dj140/ThunderScope/Hardware_V5.3_AD/FPGA_CFG_MGT_6.png

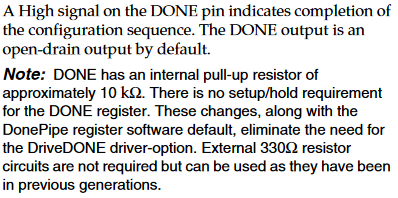
Hardware_V5.3_AD/FPGA_CFG_MGT_6.png
