dj140/ThunderScope/Hardware_V5.3_AD/FPGA_Bank_IO_1.png

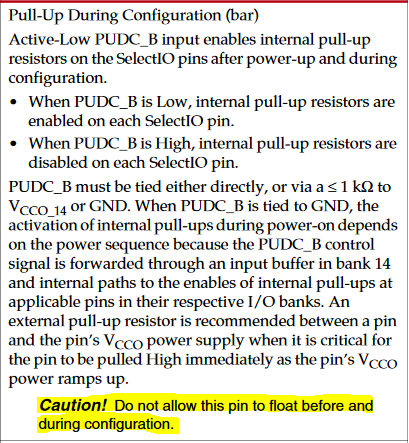
Hardware_V5.3_AD/FPGA_Bank_IO_1.png
