dj140/ThunderScope/Hardware_V5.3/Length Matching.ods

Input Net | Length | Output Net | Length |  | Total Length | Input Net Target Length | Reported Length
CH1_N | 40.2025 | 1/OUT_N | 10.1266 |  | 50.3291 | 63.8937 | 63.8717
CH1_P | 40.6287 | 1/OUT_P | 9.9265 |  | 50.5552 | 64.0938 | 64.0511
CH2_N | 39.9981 | 2/OUT_N | 5.8623 |  | 45.8604 | 68.158 | 68.1512
CH2_P | 40.4224 | 2/OUT_P | 5.861 |  | 46.2834 | 68.1593 | 68.151
CH3_N | 63.788 | 3/OUT_N | 5.8657 |  | 69.6537 | 68.1546 | 68.151
CH3_P | 64.2142 | 3/OUT_P | 5.8576 |  | 70.0718 | 68.1627 | 68.151
CH4_N | 63.4822 | 4/OUT_N | 9.9297 |  | 73.4119 | 64.0906 | 64.0984
CH4_P | 63.9084 | 4/OUT_P | 10.1119 |  | 74.0203 | 63.9084 | 63.9084
 |  |  |  | Longest | 74.0203
