dj140/ThunderScope/Hardware_V5.3_AD/FE_Channel_1.png

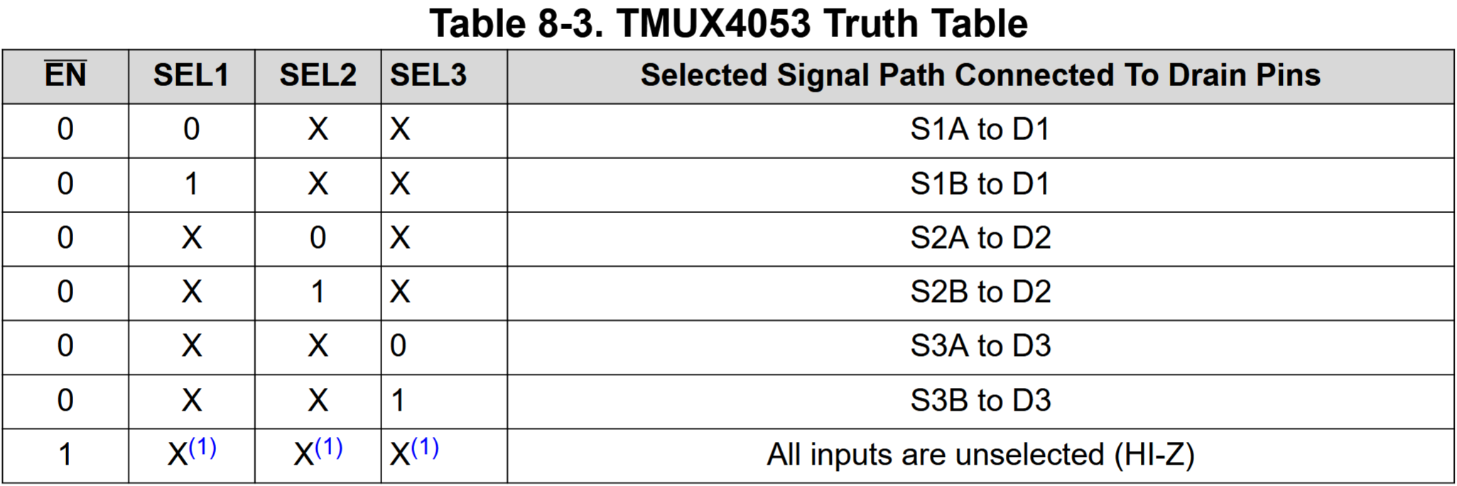
Hardware_V5.3_AD/FE_Channel_1.png
