dj140/ThunderScope/Hardware_V5.3_AD/FPGA_PWR_4.png

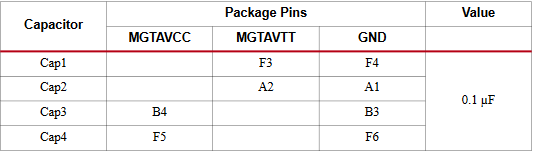
Hardware_V5.3_AD/FPGA_PWR_4.png
