dj140/ThunderScope/Hardware_V5.3_AD/PLL_1.png

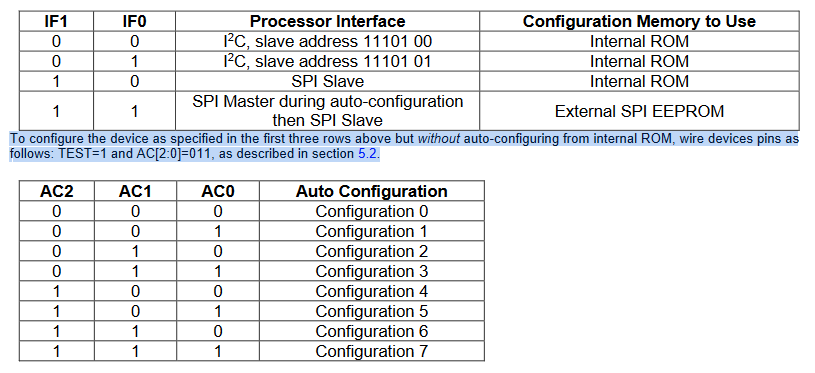
Hardware_V5.3_AD/PLL_1.png
