dj140/ThunderScope/Hardware_V5.3_AD/PnPout/Thunderscope_Rev5.3.xlsx

Comment | Designator | DesignItemId | Quantity
1uF | C1, C2, C3, C5, C6, C7, C8, C11, C16, C17, C18, C19, C24, C25, C48, C49, C50, C51, C52, C53, C54, C55, C56, C57, C58, C59, C60, C61, C62, C63, C68, C70_4_ADC Driver 1, C70_4_ADC Driver 2, C70_4_ADC Driver 3, C70_4_ADC Driver 4, C76, C78, C88, C89, C90, C91, C92, C102, C103, C104_4_ADC Driver 1, C104_4_ADC Driver 2, C104_4_ADC Driver 3, C104_4_ADC Driver 4, C105_4_ADC Driver 1, C105_4_ADC Driver 2, C105_4_ADC Driver 3, C105_4_ADC Driver 4, C112, C125, C126, C127, C130, C138, C139, C140, C141, C148, C149, C150, C151, C154, C155, C156, C157, C164, C165, C166, C167, C191, C1009_4_CH1, C1009_4_CH2, C1009_4_CH3, C1009_4_CH4, C1010_4_CH1, C1010_4_CH2, C1010_4_CH3, C1010_4_CH4, C1036_4_CH1, C1036_4_CH2, C1036_4_CH3, C1036_4_CH4, C1037_4_CH1, C1037_4_CH2, C1037_4_CH3, C1037_4_CH4, C1038_4_CH1, C1038_4_CH2, C1038_4_CH3, C1038_4_CH4, C1043_4_CH1, C1043_4_CH2, C1043_4_CH3, C1043_4_CH4, C1044_4_CH1, C1044_4_CH2, C1044_4_CH3, C1044_4_CH4, C1045_4_CH1, C1045_4_CH2, C1045_4_CH3, C1045_4_CH4, C1046_4_CH1, C1046_4_CH2, C1046_4_CH3, C1046_4_CH4, C1047_4_CH1, C1047_4_CH2, C1047_4_CH3, C1047_4_CH4, C1048_4_CH1, C1048_4_CH2, C1048_4_CH3, C1048_4_CH4, C1049_4_CH1, C1049_4_CH2, C1049_4_CH3, C1049_4_CH4, C1050_4_CH1, C1050_4_CH2, C1050_4_CH3, C1050_4_CH4, C1052_4_CH1, C1052_4_CH2, C1052_4_CH3, C1052_4_CH4, C1053_4_CH1, C1053_4_CH2, C1053_4_CH3, C1053_4_CH4, C1054_4_CH1, C1054_4_CH2, C1054_4_CH3, C1054_4_CH4, C1055_4_CH1, C1055_4_CH2, C1055_4_CH3, C1055_4_CH4, C1056_4_CH1, C1056_4_CH2, C1056_4_CH3, 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 | CAP 1uF 25V X5R 0402 | 150
100pF | C4, C74, C174, C178, C186, C1001_4_CH1, C1001_4_CH2, C1001_4_CH3, C1001_4_CH4, C1034_4_CH1, C1034_4_CH2, C1034_4_CH3, C1034_4_CH4, C1035_4_CH1, C1035_4_CH2, C1035_4_CH3, C1035_4_CH4 | CAP 100pF 50V C0G 0402 | 17
10uF | C9, C10, C14, C15, C20, C21, C23, C26, C69_4_ADC Driver 1, C69_4_ADC Driver 2, C69_4_ADC Driver 3, C69_4_ADC Driver 4, C71, C72, C73, C79, C85, C93, C94, C95, C96, C106, C107, C108, C109, C110, C111, C114, C115, C116, C117, C118, C119, C120, C121, C122, C142, C143, C146, C147, C158, C159, C162, C163, C168, C173, C175, C179, C181, C182, C183, C184, C187, C1003_4_CH1, C1003_4_CH2, C1003_4_CH3, C1003_4_CH4, C1004_4_CH1, C1004_4_CH2, C1004_4_CH3, C1004_4_CH4, C1005_4_CH1, C1005_4_CH2, C1005_4_CH3, C1005_4_CH4, C1006_4_CH1, C1006_4_CH2, C1006_4_CH3, C1006_4_CH4, C1007_4_CH1, C1007_4_CH2, C1007_4_CH3, C1007_4_CH4, C1008_4_CH1, C1008_4_CH2, C1008_4_CH3, C1008_4_CH4, C1039_4_CH1, C1039_4_CH2, C1039_4_CH3, C1039_4_CH4, C1040_4_CH1, C1040_4_CH2, C1040_4_CH3, C1040_4_CH4 | CAP 10uF 25V X5R 0603 | 85
22uF | C12, C22, C75, C80, C83, C84, C97, C98, C99, C101, C128, C176, C177, C180, C188, C1026_4_CH1, C1026_4_CH2, C1026_4_CH3, C1026_4_CH4, C1027_4_CH1, C1027_4_CH2, C1027_4_CH3, C1027_4_CH4, C1028_4_CH1, C1028_4_CH2, C1028_4_CH3, C1028_4_CH4, C1029_4_CH1, C1029_4_CH2, C1029_4_CH3, C1029_4_CH4 | CAP 22uF 25V X5R 0805 | 31
100nF | C13, C27, C44, C45, C46, C47, C65, C66, C67, C77, C81, C82, C123, C124, C129, C169, C170, C171, C172, C185, C189, C190, C1032_4_CH1, C1032_4_CH2, C1032_4_CH3, C1032_4_CH4, C1033_4_CH1, C1033_4_CH2, C1033_4_CH3, C1033_4_CH4, C1041_4_CH1, C1041_4_CH2, C1041_4_CH3, C1041_4_CH4, C1042_4_CH1, C1042_4_CH2, C1042_4_CH3, C1042_4_CH4 | CAP 100nF 16V X7R 0402 | 38
220nF | C28, C29, C30, C31, C32, C33, C34, C35, C36, C37, C38, C39, C40, C41, C42, C43 | CAP 220nF 16V X7R 0402 | 16
0 | C64, R2, R3, R4, R5, R25, R26, R27, R28, R29, R30, R31, R32, R33, R34, R35, R36, R37, R38, R39, R40, R41, R52_4_CH1, R52_4_CH2, R52_4_CH3, R52_4_CH4, R97_4_CH1, R97_4_CH2, R97_4_CH3, R97_4_CH4, R1053_4_CH1, R1053_4_CH2, R1053_4_CH3, R1053_4_CH4 | RES 0 OHM 1/16W 0402 | 34
47uF | C86, C87, C144, C145, C152, C153, C160, C161 | CAP 47uF 6.3V X5R 0805 | 8
18pF | C100, C1058_4_CH1, C1058_4_CH2, C1058_4_CH3, C1058_4_CH4 | CAP 18pF 50V C0G 0402 | 5
68pF | C1002_4_CH1, C1002_4_CH2, C1002_4_CH3, C1002_4_CH4 | CAP 68pF 50V C0G 0402 | 4
3pF | C1011_4_CH1, C1011_4_CH2, C1011_4_CH3, C1011_4_CH4, C1021_4_CH1, C1021_4_CH2, C1021_4_CH3, C1021_4_CH4, C1023_4_CH1, C1023_4_CH2, C1023_4_CH3, C1023_4_CH4 | CAP 3pF 200V C0G 0402 | 12
0.3pF | C1012_4_CH1, C1012_4_CH2, C1012_4_CH3, C1012_4_CH4 | CAP 0.3pF 100V Thin Film 0402 | 4
DNP | C1022_4_CH1, C1022_4_CH2, C1022_4_CH3, C1022_4_CH4 | CAP DNP 0603 | 4
1pF | C1024_4_CH1, C1024_4_CH2, C1024_4_CH3, C1024_4_CH4 | CAP 1pF 50V C0G 0402 | 4
8pF | C1025_4_CH1, C1025_4_CH2, C1025_4_CH3, C1025_4_CH4 | CAP 8pF 50V C0G 0402 | 4
1nF | C1030_4_CH1, C1030_4_CH2, C1030_4_CH3, C1030_4_CH4 | CAP 1nF 100V C0G 0603 | 4
10nF | C1031_4_CH1, C1031_4_CH2, C1031_4_CH3, C1031_4_CH4 | CAP 10nF 50V C0G 0603 | 4
2-6pF | C1059_4_CH1, C1059_4_CH2, C1059_4_CH3, C1059_4_CH4 | CAP TRIMMER 2-6PF 100V | 4
RGB | D1 | LED RGB 1204 APFA3010LSEKJ3ZGKQBC | 1
TPD1E1B04 | D2, D3, D4, D5 | TVS TPD1E1B04 | 4
1N4148WT-7 | D1000_4_CH1, D1000_4_CH2, D1000_4_CH3, D1000_4_CH4, D1001_4_CH1, D1001_4_CH2, D1001_4_CH3, D1001_4_CH4 | DIODE 1N4148 | 8
120@100MHZ | FB1, FB2, FB3, FB11, FB12, FB13, FB1000_4_CH1, FB1000_4_CH2, FB1000_4_CH3, FB1000_4_CH4, FB1001_4_CH1, FB1001_4_CH2, FB1001_4_CH3, FB1001_4_CH4, R91 | FERRITE BEAD 120 OHM 0402 | 15
BNC | J1, J2, J1002_4_CH1, J1002_4_CH2, J1002_4_CH3, J1002_4_CH4 | BNC JACK R/A | 6
1.27mm 6 Pin TH | J3 | CONN 1.27mm 2x5 Pin TH RA | 1
UFL | J3_4_CH1, J3_4_CH2, J3_4_CH3, J3_4_CH4, J4_4_CH1, J4_4_CH2, J4_4_CH3, J4_4_CH4 | UFL Jack SMD | 8
TSW-101-16-G-Q-RA | J4 | CONN 5.08mm 2 Pin TH RA | 1
2.54mm 6 Pin TH | J5 | CONN 2.54mm 6 Pin TH RA | 1
M.2 Key M | J8 | CONN M.2 Key M FEMALE | 1
F300-1B7H1-11036-E100 | J9 | CONN FFC BOTTOM 36POS 0.5MM RA | 1
HC-1.25-2PLT | J10 | CONN 1.27mm 2PIN | 1
UD2-4.5NUN-L | K1000_4_CH1, K1000_4_CH2, K1000_4_CH3, K1000_4_CH4, K1001_4_CH1, K1001_4_CH2, K1001_4_CH3, K1001_4_CH4 | RELAY DPDT-NO UD2-4.5NUN-L | 8
1uH | L1, L2, L3, L4, L5 | IND 1uH 5.5A 32 MOHM 1210 | 5
DMN62D0UW | Q1, Q2, Q3, Q1002_4_CH1, Q1002_4_CH2, Q1002_4_CH3, Q1002_4_CH4, Q1003_4_CH1, Q1003_4_CH2, Q1003_4_CH3, Q1003_4_CH4 | NMOS DMN62D0UW | 11
10K | R1, R8, R15, R16, R17, R45, R58, R59, R61, R62, R66, R67, R68, R72, R75, R76, R77, R78, R79, R80, R81, R82, R86, R87, R92, R94, R101, R108, R111, R117, R118, R121, R124, R128, R129, R130, R1029_4_CH1, R1029_4_CH2, R1029_4_CH3, R1029_4_CH4, R1030_4_CH1, R1030_4_CH2, R1030_4_CH3, R1030_4_CH4, R1031_4_CH1, R1031_4_CH2, R1031_4_CH3, R1031_4_CH4, R1032_4_CH1, R1032_4_CH2, R1032_4_CH3, R1032_4_CH4, R1033_4_CH1, R1033_4_CH2, R1033_4_CH3, R1033_4_CH4, R1044_4_CH1, R1044_4_CH2, R1044_4_CH3, R1044_4_CH4, R1052_4_CH1, R1052_4_CH2, R1052_4_CH3, R1052_4_CH4 | RES 10K OHM 1% 1/16W 0402 | 64
2K | R6, R64, R127, R1043_4_CH1, R1043_4_CH2, R1043_4_CH3, R1043_4_CH4 | RES 2K OHM 1% 1/16W 0402 | 7
100 | R7, R22, R60, R107, R112, R115 | RES 100 OHM 1% 1/10W 0402 | 6
4.7K | R9, R10, R11, R12, R46, R47, R69, R70, R73, R99, R102, R104, R113, R114, R119 | RES 4.7K OHM 1% 1/16W 0402 | 15
10K | R13 | RES ARRAY 2x 10K OHM 0.05% 0606 | 1
0.01 | R14, R42, R54, R57, R71, R89, R97, R98, R116, R120, R123, R126 | RES 0.01 OHM 1% 1/4W 0603 | 12
DNP | R18, R19, R20, R21, R1048_4_CH1, R1048_4_CH2, R1048_4_CH3, R1048_4_CH4 | RES DNP 0402 | 8
49.9 | R23, R24, R43, R63, R1037_4_CH1, R1037_4_CH2, R1037_4_CH3, R1037_4_CH4 | RES 49.9 OHM 1% 1/10W 0402 | 8
1K | R44, R48, R49, R50, R51, R52, R53, R65, R74, R85, R95, R125, R1001_4_CH1, R1001_4_CH2, R1001_4_CH3, R1001_4_CH4, R1045_4_CH1, R1045_4_CH2, R1045_4_CH3, R1045_4_CH4, R1046_4_CH1, R1046_4_CH2, R1046_4_CH3, R1046_4_CH4 | RES 1K OHM 1% 1/10W 0402 | 24
90.9k | R55, R96, R1041_4_CH1, R1041_4_CH2, R1041_4_CH3, R1041_4_CH4, R1042_4_CH1, R1042_4_CH2, R1042_4_CH3, R1042_4_CH4, R1047_4_CH1, R1047_4_CH2, R1047_4_CH3, R1047_4_CH4 | RES 90.9K OHM 1% 1/16W 0402 | 14
20k | R56, R100, R103, R105, R122, R1026_4_CH1, R1026_4_CH2, R1026_4_CH3, R1026_4_CH4 | RES 20K OHM 1% 1/16W 0402 | 9
35.7k | R88, R110, R1036_4_CH1, R1036_4_CH2, R1036_4_CH3, R1036_4_CH4 | RES 35.7K OHM 1% 1/16W 0402 | 6
0.1 | R90, R106 | RES 0.1 OHM 1% 1/6W 0402 | 2
280K | R93, R109 | RES 280K OHM 1% 1/16W 0402 | 2
120 | R131_4_ADC Driver 1, R131_4_ADC Driver 2, R131_4_ADC Driver 3, R131_4_ADC Driver 4 | RES 120 OHM 1% 1/16W 0402 | 4
300 | R132_4_ADC Driver 1, R132_4_ADC Driver 2, R132_4_ADC Driver 3, R132_4_ADC Driver 4, R133_4_ADC Driver 1, R133_4_ADC Driver 2, R133_4_ADC Driver 3, R133_4_ADC Driver 4, R134_4_ADC Driver 1, R134_4_ADC Driver 2, R134_4_ADC Driver 3, R134_4_ADC Driver 4, R135_4_ADC Driver 1, R135_4_ADC Driver 2, R135_4_ADC Driver 3, R135_4_ADC Driver 4 | RES 300 OHM 0.1% 1/16W 0402 | 16
4.99 | R136_4_ADC Driver 1, R136_4_ADC Driver 2, R136_4_ADC Driver 3, R136_4_ADC Driver 4, R137_4_ADC Driver 1, R137_4_ADC Driver 2, R137_4_ADC Driver 3, R137_4_ADC Driver 4 | RES 4.99 OHM 1% 1/16W 0402 | 8
976k | R1002_4_CH1, R1002_4_CH2, R1002_4_CH3, R1002_4_CH4, R1024_4_CH1, R1024_4_CH2, R1024_4_CH3, R1024_4_CH4 | RES 976k OHM 1% 1/10W 0402 | 8
10M | R1003_4_CH1, R1003_4_CH2, R1003_4_CH3, R1003_4_CH4, R1038_4_CH1, R1038_4_CH2, R1038_4_CH3, R1038_4_CH4 | RES 10M OHM 1% 1/10W 0603 | 8
15 | R1021_4_CH1, R1021_4_CH2, R1021_4_CH3, R1021_4_CH4 | RES 15 OHM 1% 1/3W 0603 | 4
30 | R1022_4_CH1, R1022_4_CH2, R1022_4_CH3, R1022_4_CH4, R1035_4_CH1, R1035_4_CH2, R1035_4_CH3, R1035_4_CH4 | RES 30 OHM 1% 1/3W 0603 | 8
49.9 | R1025_4_CH1, R1025_4_CH2, R1025_4_CH3, R1025_4_CH4 | RES 49.9 OHM 1% 1W 0508 | 4
22 | R1027_4_CH1, R1027_4_CH2, R1027_4_CH3, R1027_4_CH4, R1028_4_CH1, R1028_4_CH2, R1028_4_CH3, R1028_4_CH4 | RES 22 OHM 1% 1/3W 0603 | 8
909k | R1039_4_CH1, R1039_4_CH2, R1039_4_CH3, R1039_4_CH4 | RES 909K OHM 1% 1/16W 0402 | 4
2K TRIMPOT | R1049_4_CH1, R1049_4_CH2, R1049_4_CH3, R1049_4_CH4 | TRIMMER 2K OHM 0.1W J LEAD TOP | 4
2118728-2 | SHLD1001_4_CH1, SHLD1001_4_CH2, SHLD1001_4_CH3, SHLD1001_4_CH4 | SHIELD 2118728-2 | 4
SN74LVC1G17 | U1 | IC BUFFER SN74LVC1G17 | 1
MCP4452-104E | U2 | IC DIGIPOT QUAD MCP4452-104E | 1
MCP4728 | U3 | IC DAC QUAD MCP4728 | 1
REF2025 | U4 | IC VREF REF2025 | 1
OPA140AIDBVR | U5, U1011_4_CH1, U1011_4_CH2, U1011_4_CH3, U1011_4_CH4 | IC OPAMP OPA140 | 5
HMCAD1520 | U6 | IC ADC HMCAD1520 | 1
ZL30260LDG1 | U7 | IC CLK GEN ZL30260LDG1 | 1
TPS62A02 | U8, U20, U21, U23 | IC BUCK TPS62A02 | 4
NCP161ASN330T1G | U9, U16 | IC LDO NCP161ASN330T1G | 2
FIN1019MTCX | U10 | IC LVDS XCVR FIN1019MTCX | 1
TPSM82913 | U11 | IC BUCK MODULE TPSM82913 | 1
ADA4930-1YCPZ | U12_4_ADC Driver 1, U12_4_ADC Driver 2, U12_4_ADC Driver 3, U12_4_ADC Driver 4 | IC ADC DRIVER ADA4930-1YCPZ | 4
LM27761 | U13 | IC CPUMP LM27761 | 1
TPS7A9101 | U14, U15, U22 | IC LDO TPS7A9101 | 3
TPS61023 | U17 | IC BOOST TPS61023 | 1
IC FPGA XC7A50T-2CSG325C | U18 | IC FPGA XC7A50T-2CSG325C | 1
MX25L6433FZNI-08G | U19 | IC FLASH MX25L6433FZNI-08G | 1
TMUX4053 | U1001_4_CH1, U1001_4_CH2, U1001_4_CH3, U1001_4_CH4 | IC SWITCH 3X SPDT TMUX4053 | 4
LMH6518 | U1008_4_CH1, U1008_4_CH2, U1008_4_CH3, U1008_4_CH4 | IC PGA LMH6518 | 4
BUF802 | U1009_4_CH1, U1009_4_CH2, U1009_4_CH3, U1009_4_CH4 | IC BUFFER AMP BUF802 | 4
10MHz | Y1 | OSC 10MHz ECS-TXO-3225MV | 1
25MHz | Y2 | OSC 25MHz ECS-TXO-2016 | 1
