dj140/ThunderScope/Hardware_V5.3_AD/PnPout/Thunderscope_Rev5.3.pdf

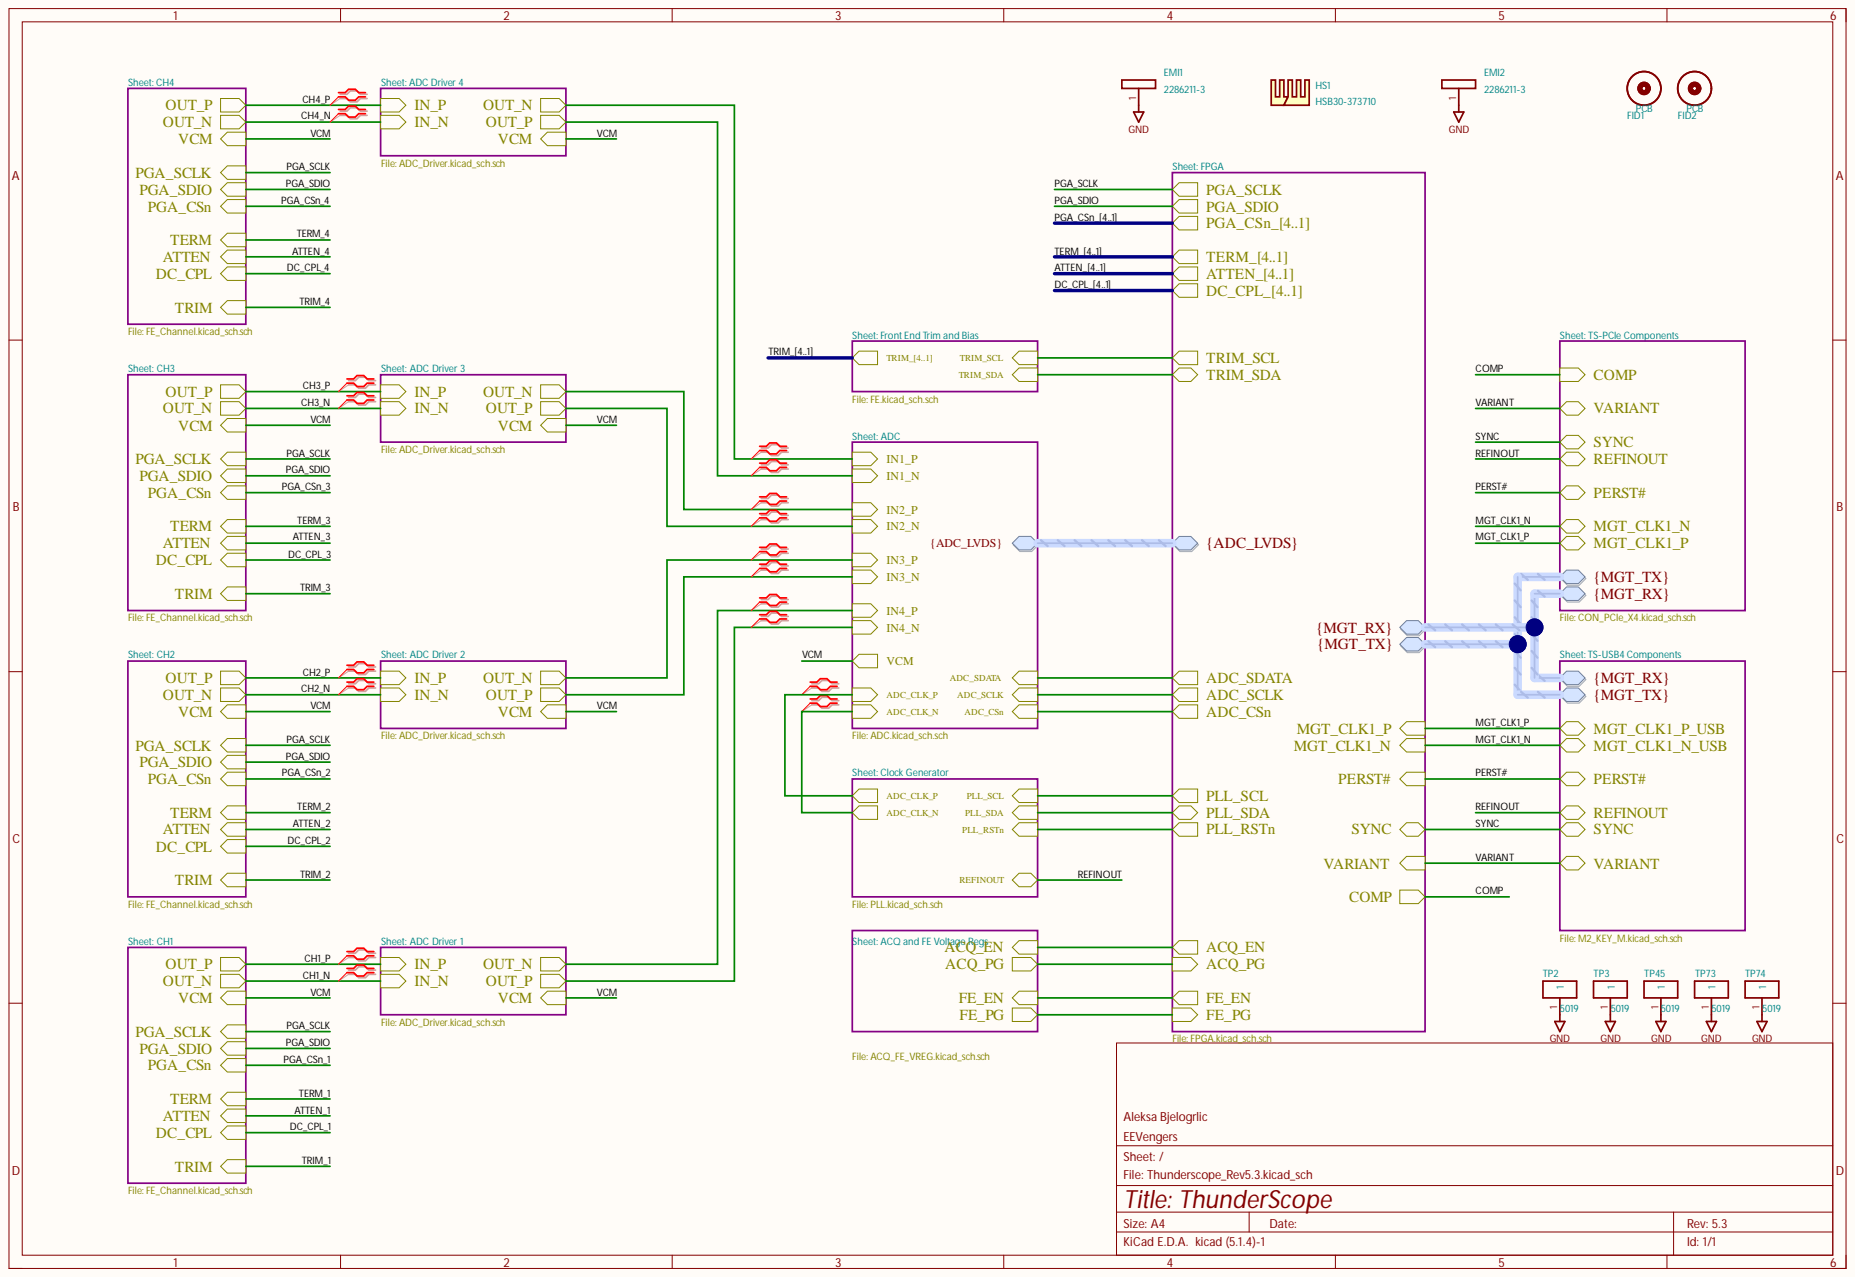
[picture p7: page 1]

Size: A4 | Date: | Rev: 5.3
K i Cad E.D.A. k i cad (5.1.4)-1 | | Id: 1/1

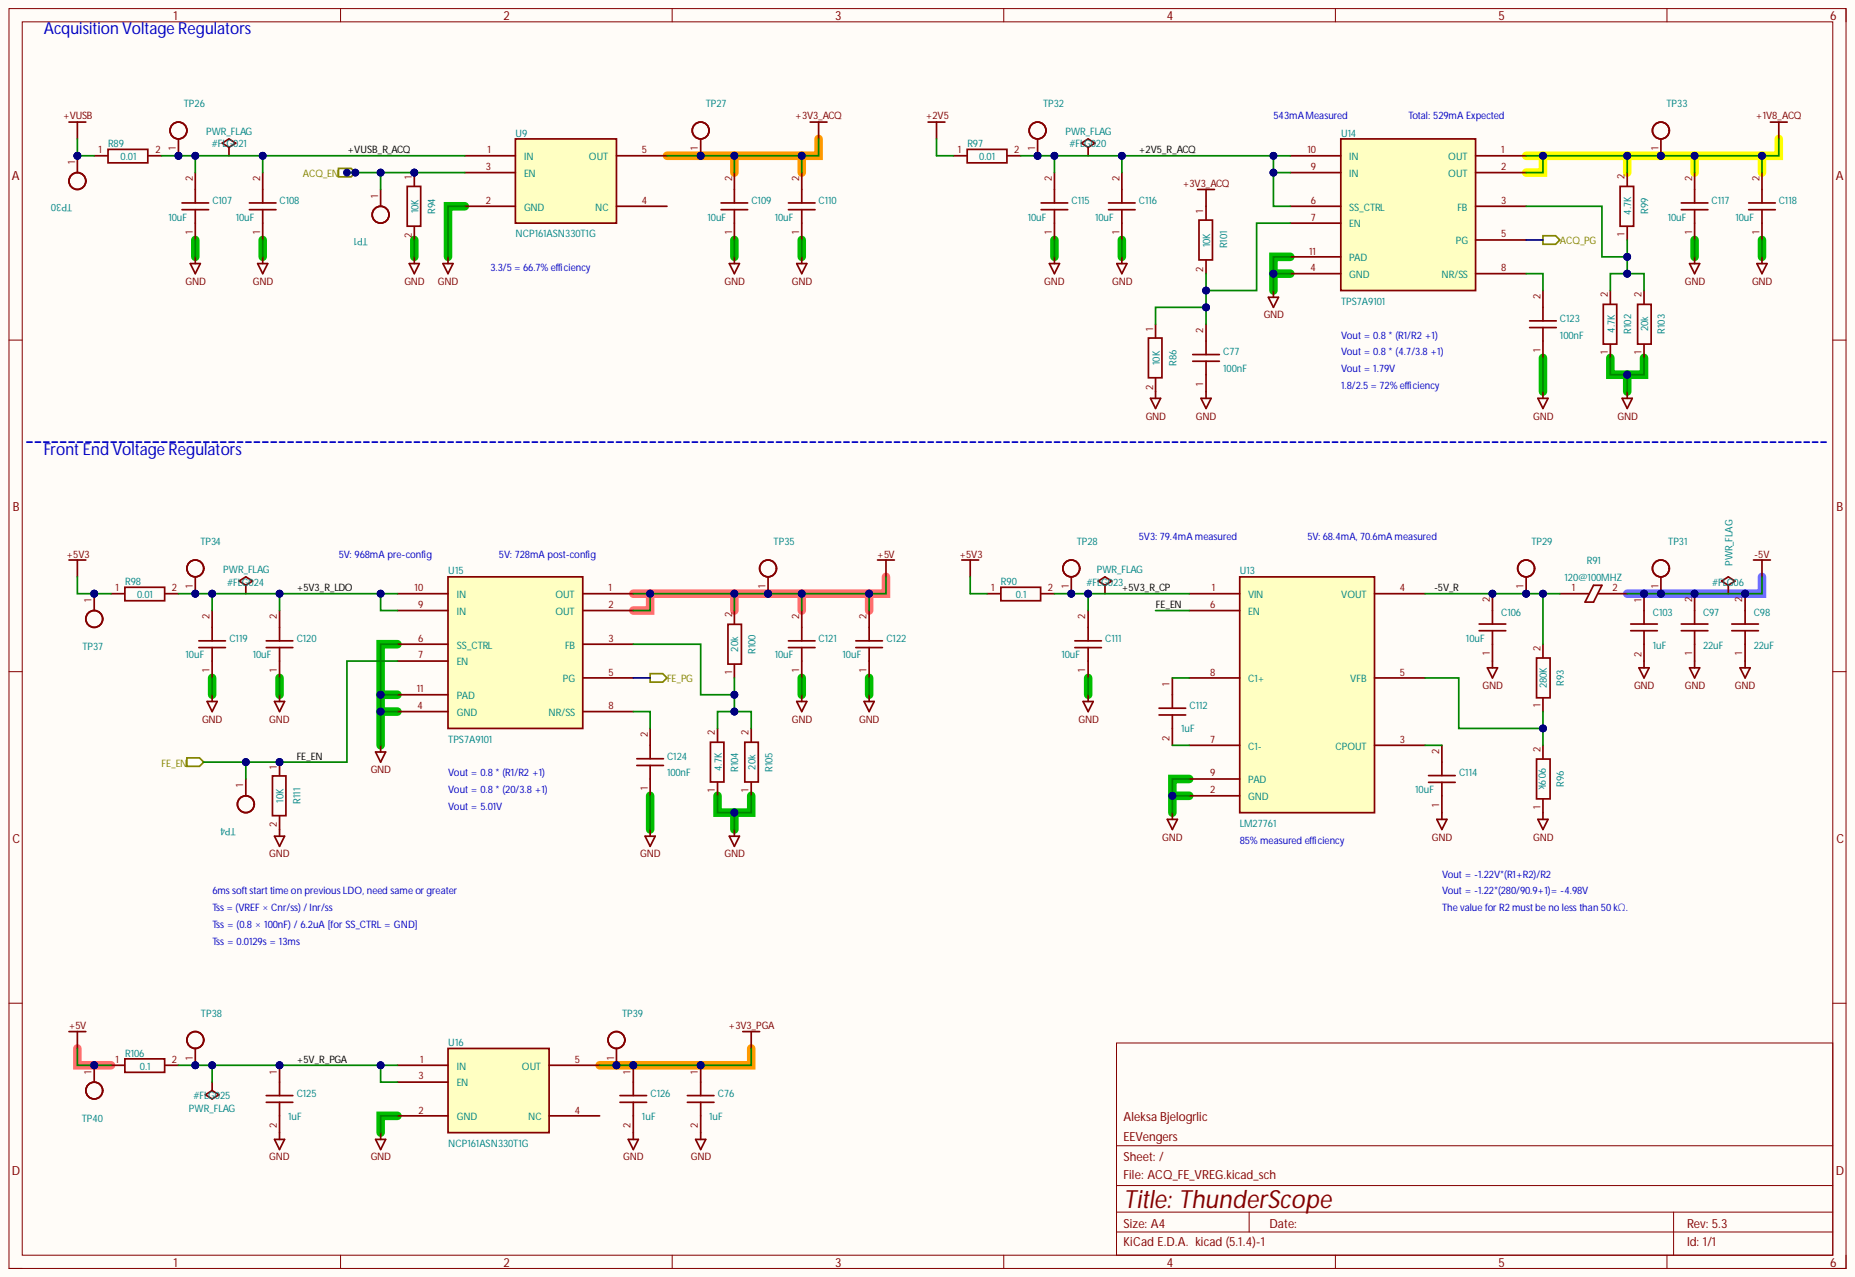
[picture p8: page 2]

Front End Voltage Regulators

6ms soft start time on previous LDO, need same or greater
Tss = (0.8 × 100nF) / 6.2uA [for SS_CTRL = GND]
Tss = 0.0129s = 13ms

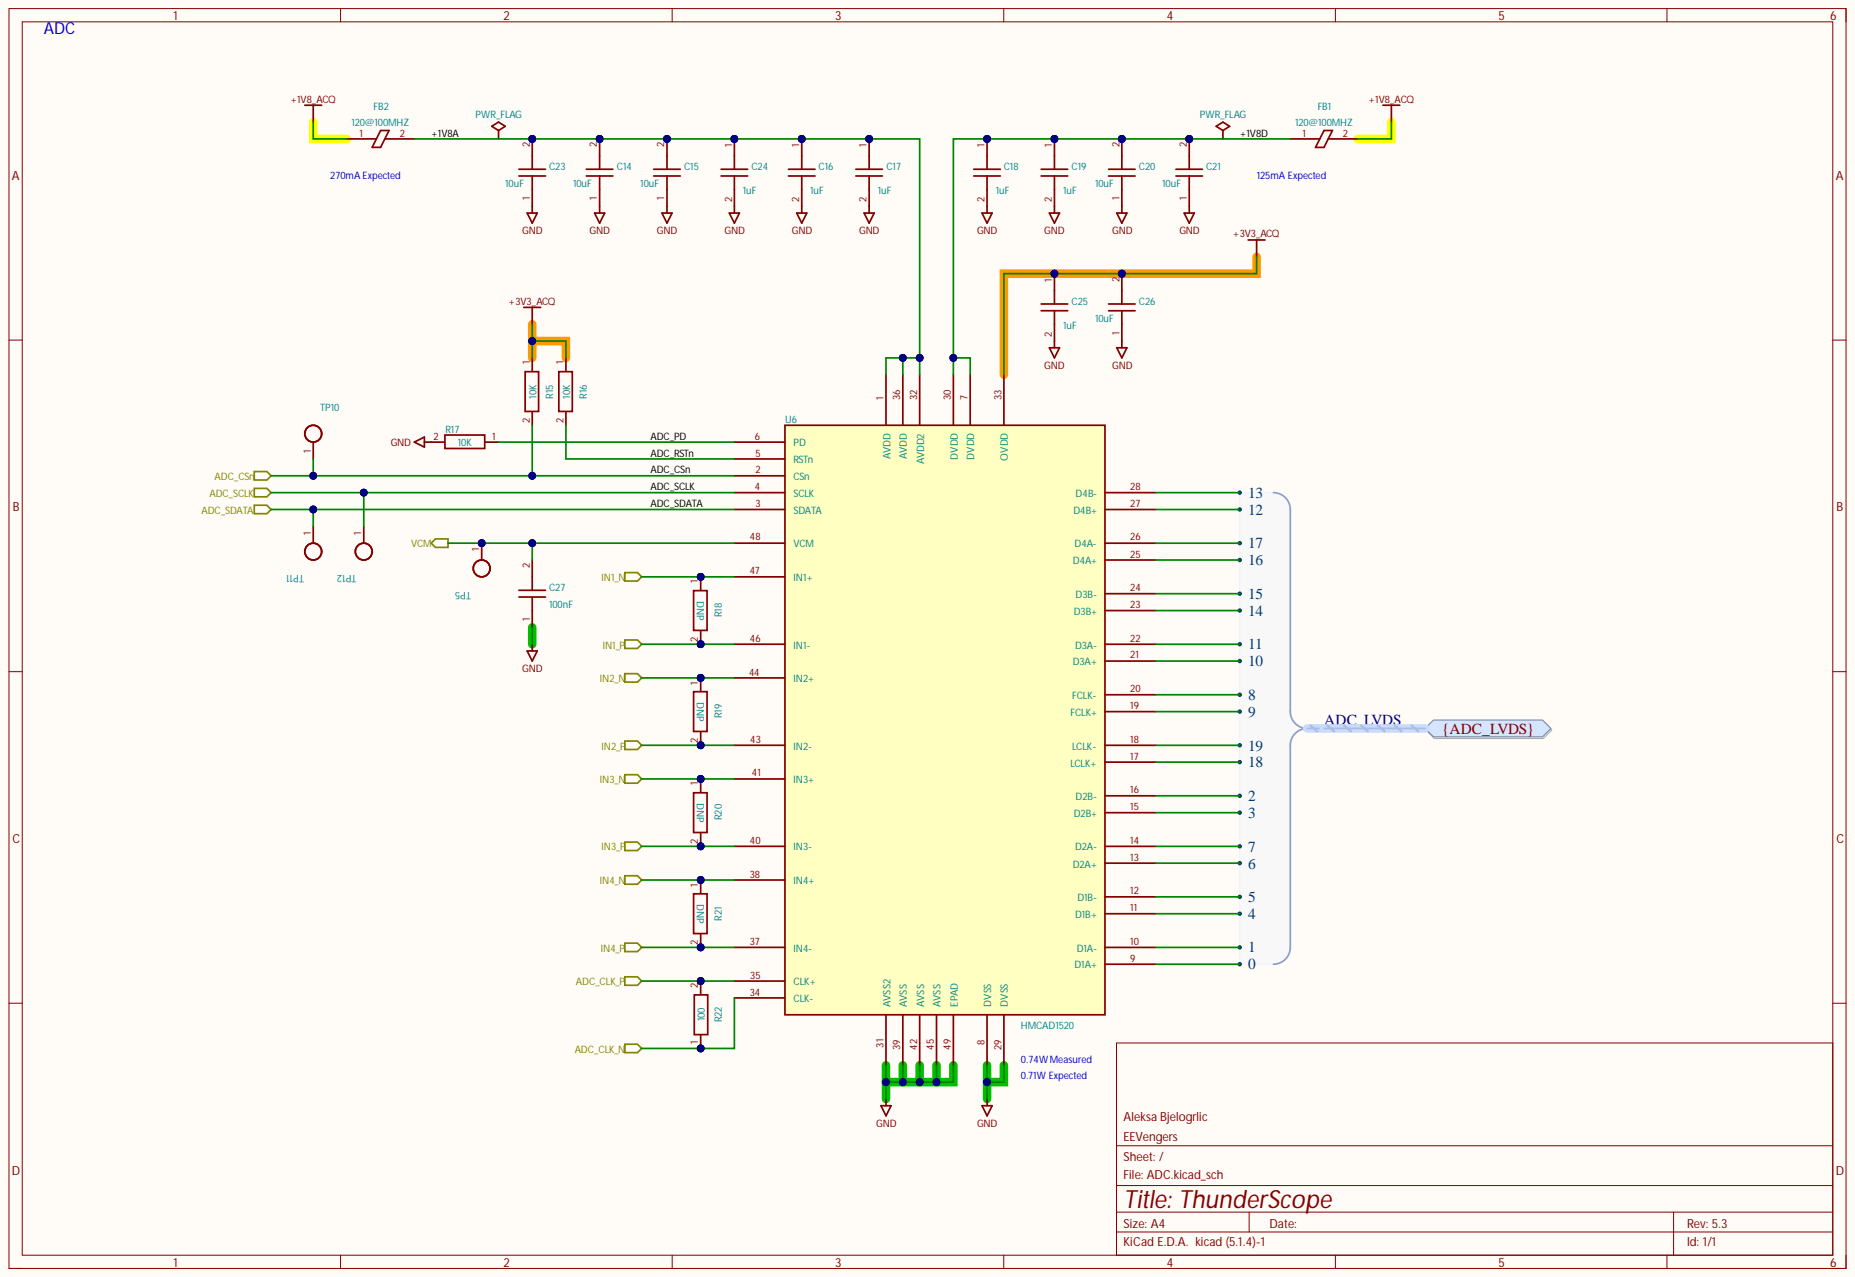
[picture p9: page 3]

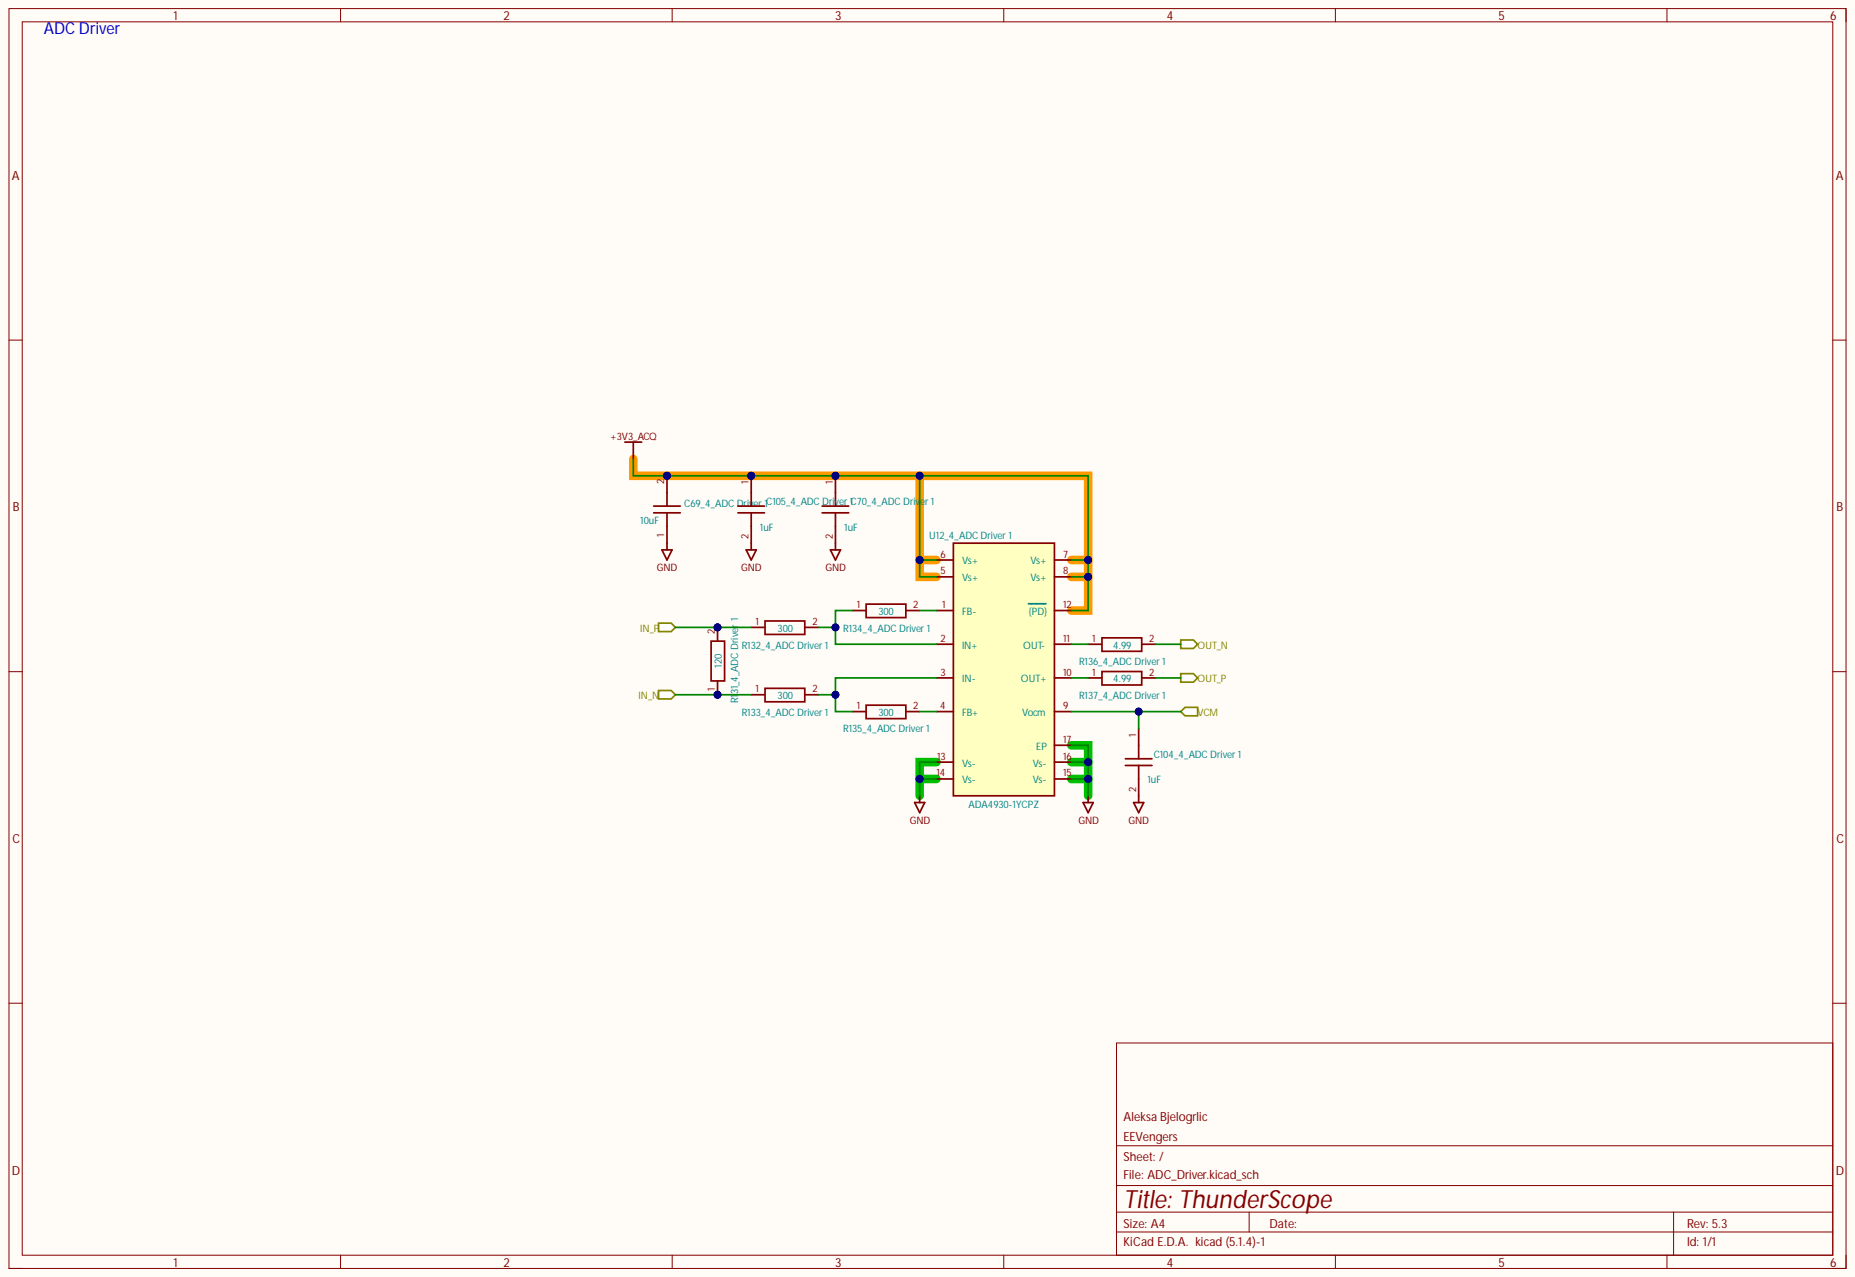
[picture p10: page 4]

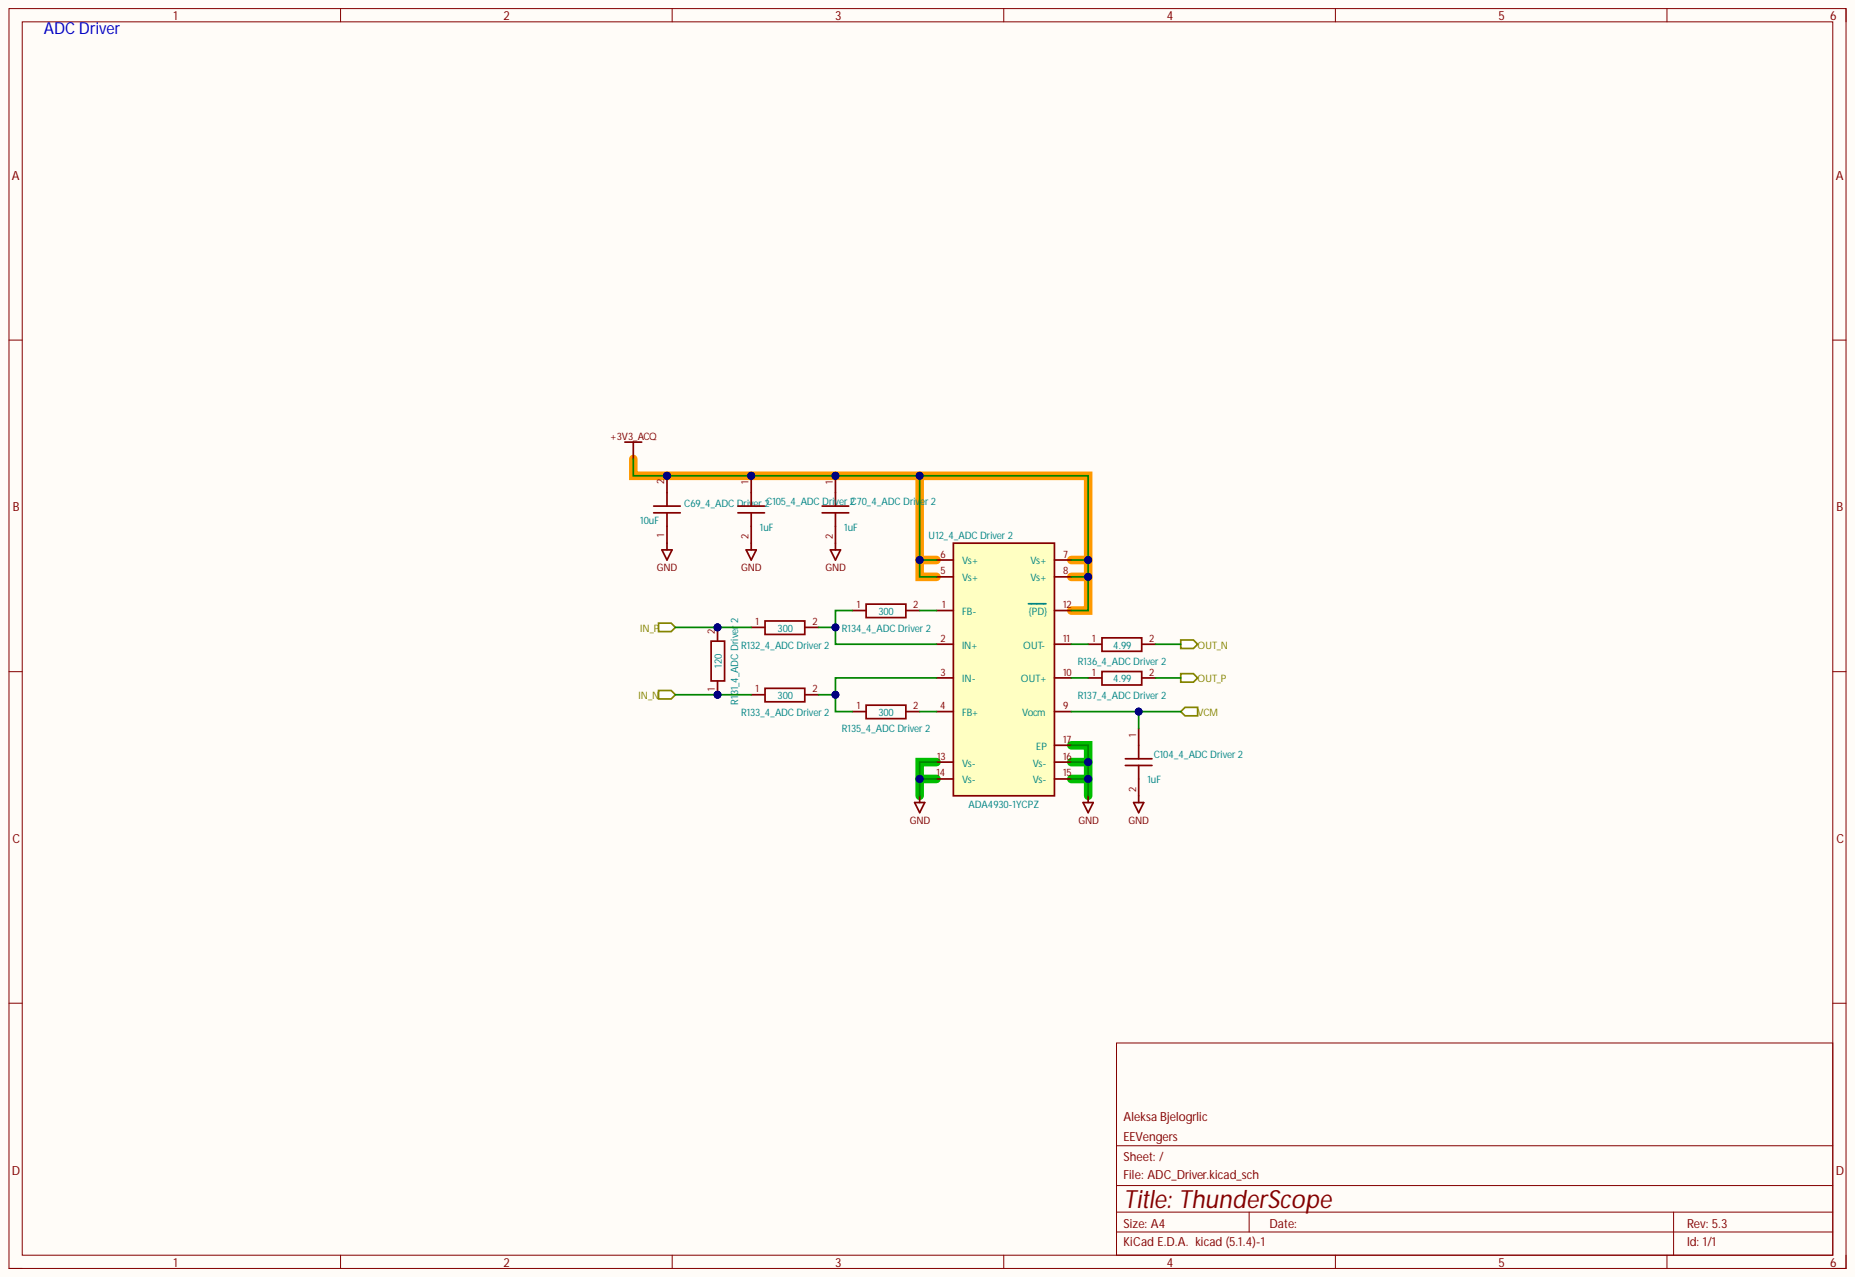
[picture p11: page 5]

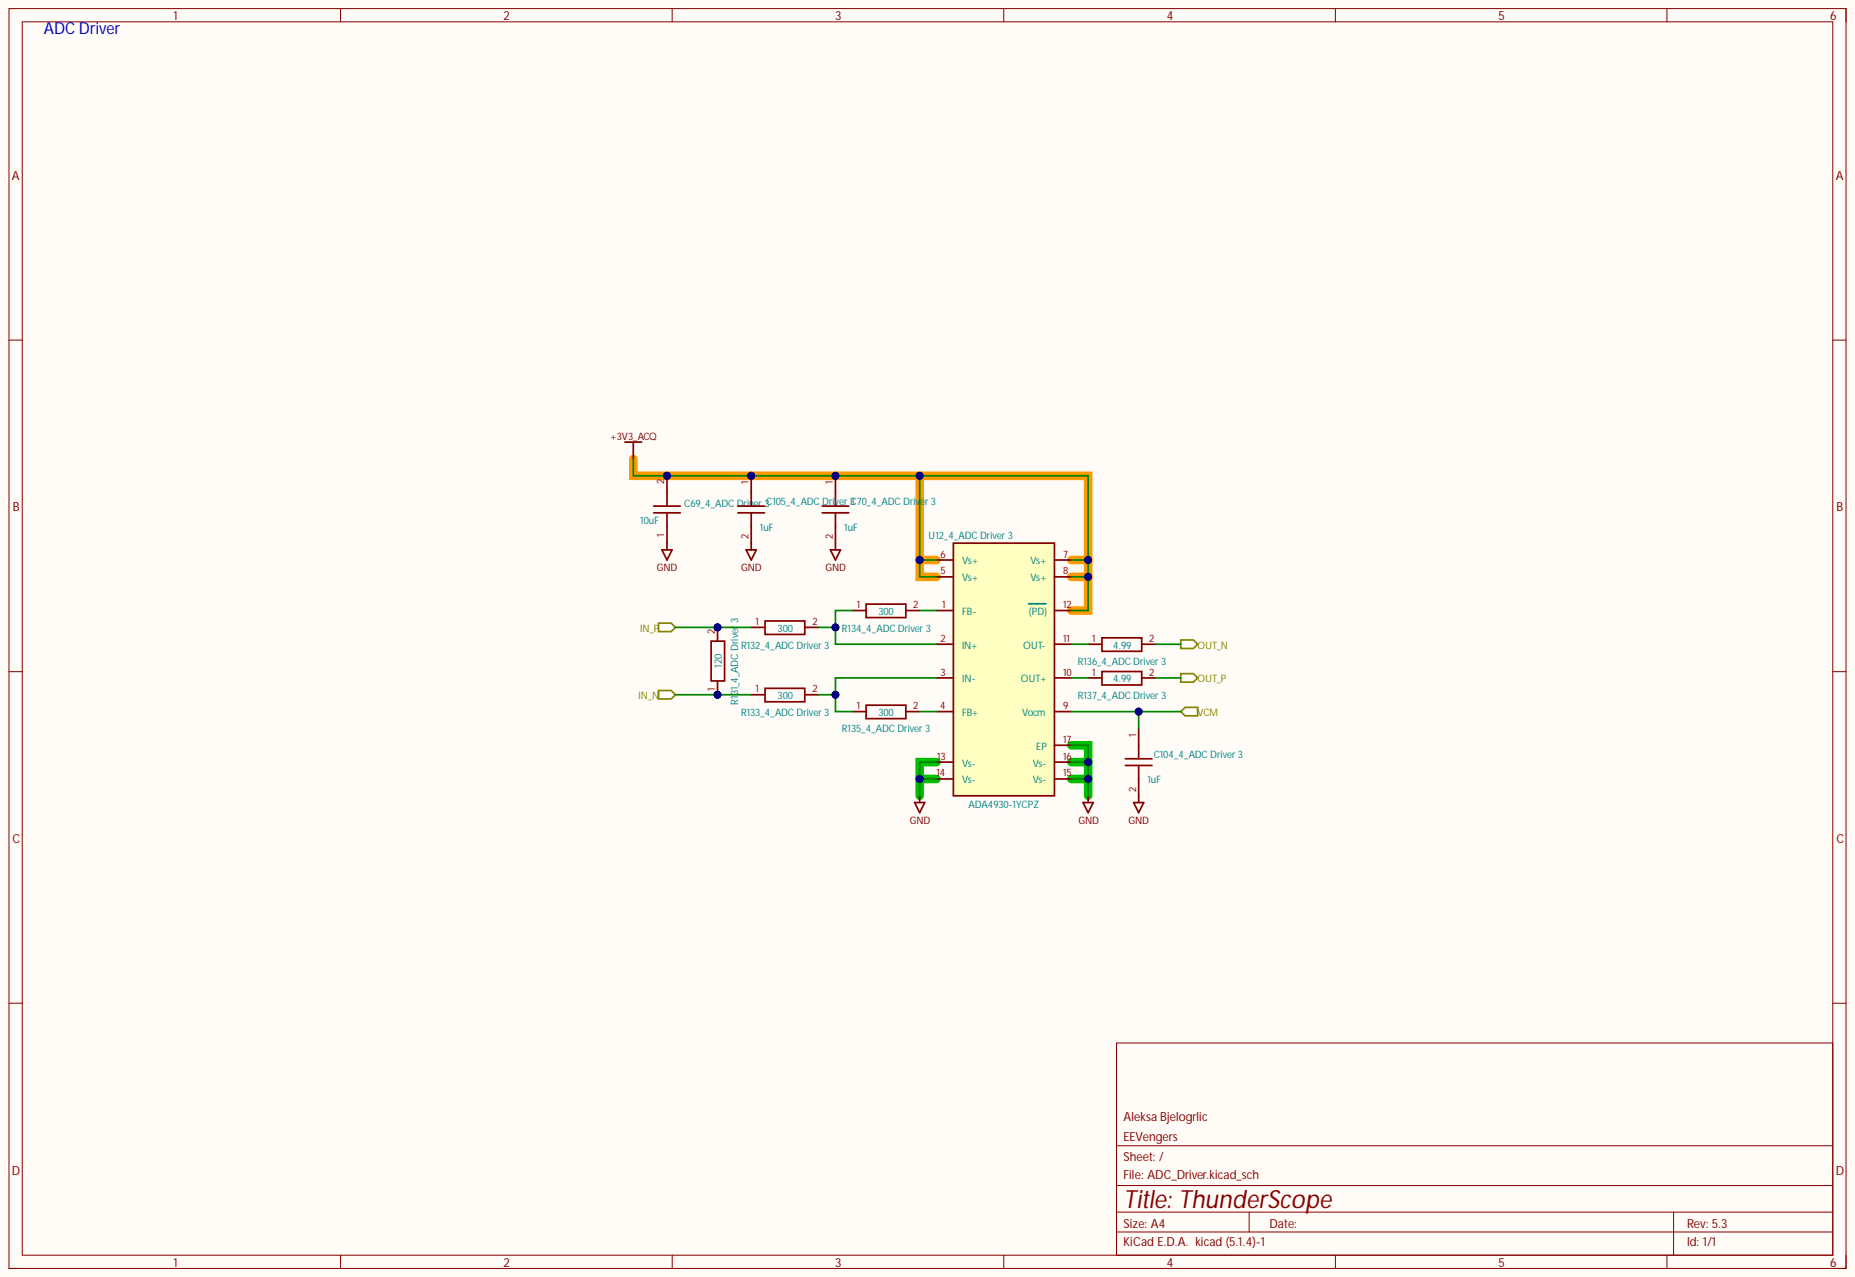
[picture p12: page 6]

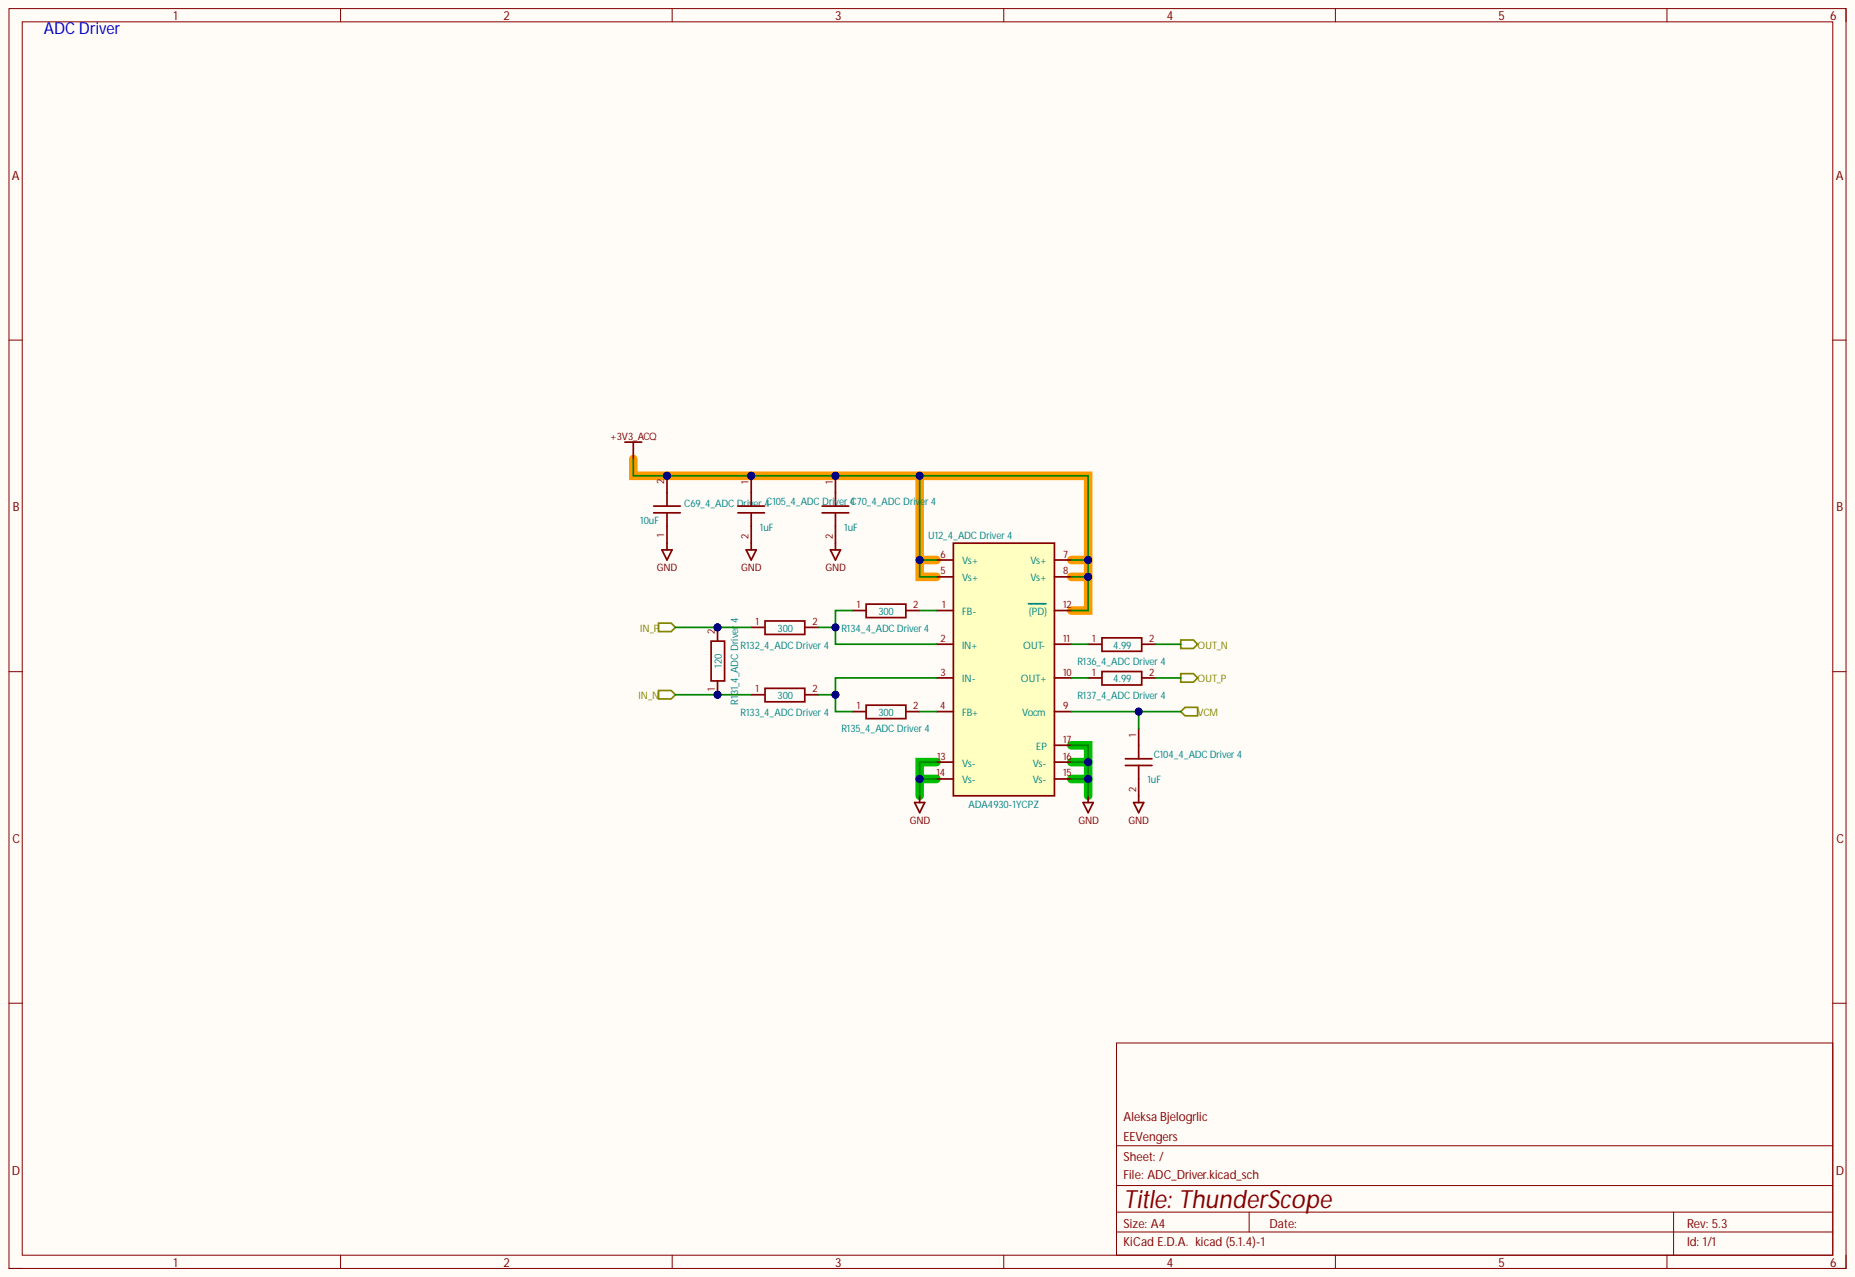
[picture p13: page 7]

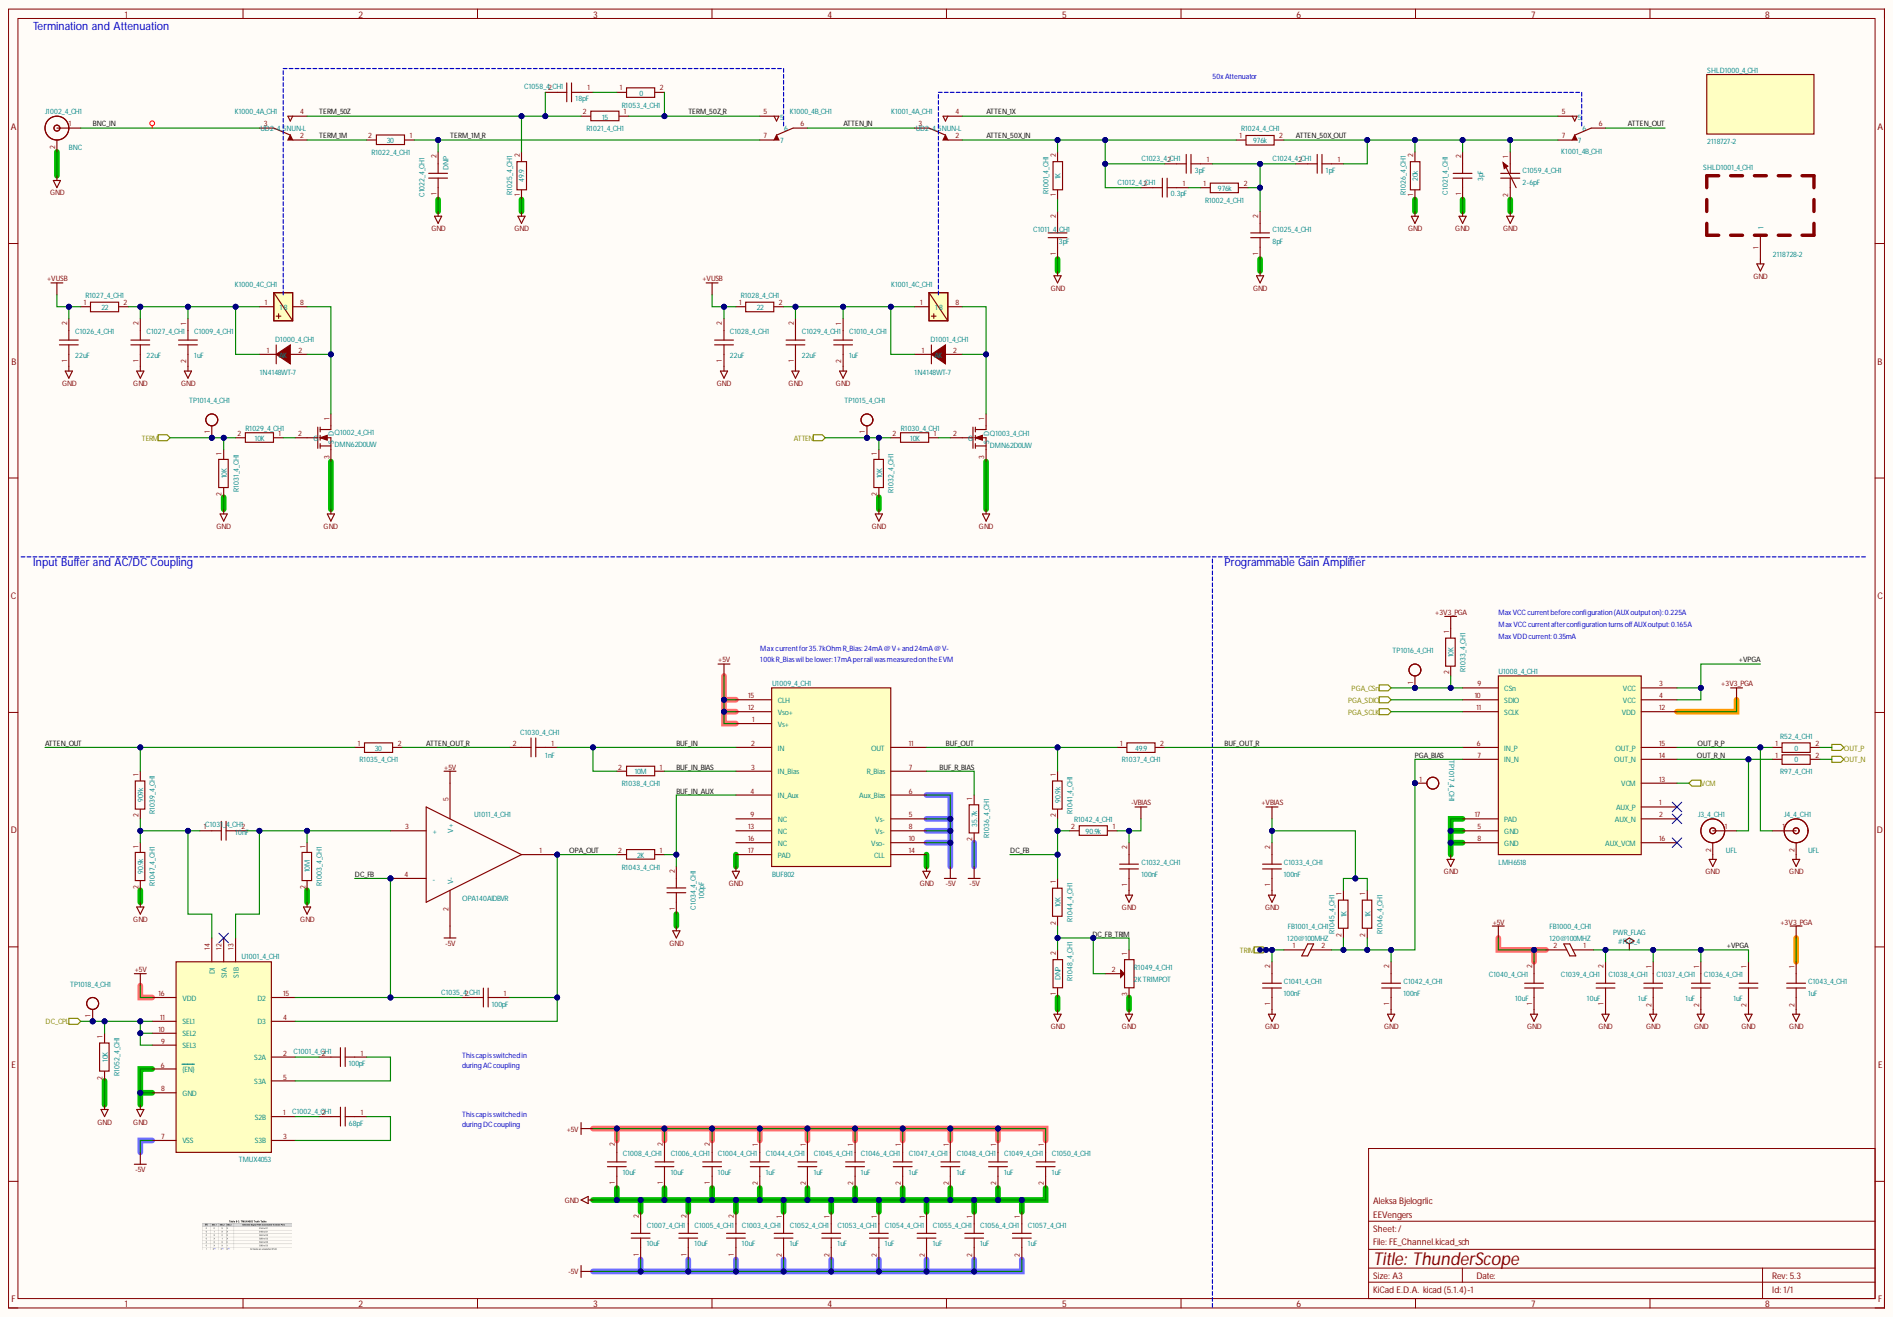
[picture p14: page 8]

Input Buffer and AC/DC Coupling

Max VCC current before configuration (AUXoutput on): 0.225A
Max VCC current after configuration turns off AUXoutput: 0.165A
Max VDD current: 0.35mA

Max current for 35.7kOhm R_Bias: 24mA@V+and 24mA@V-
100k R_Bias wil be lower: 17mAperrail was measuredon the EVM

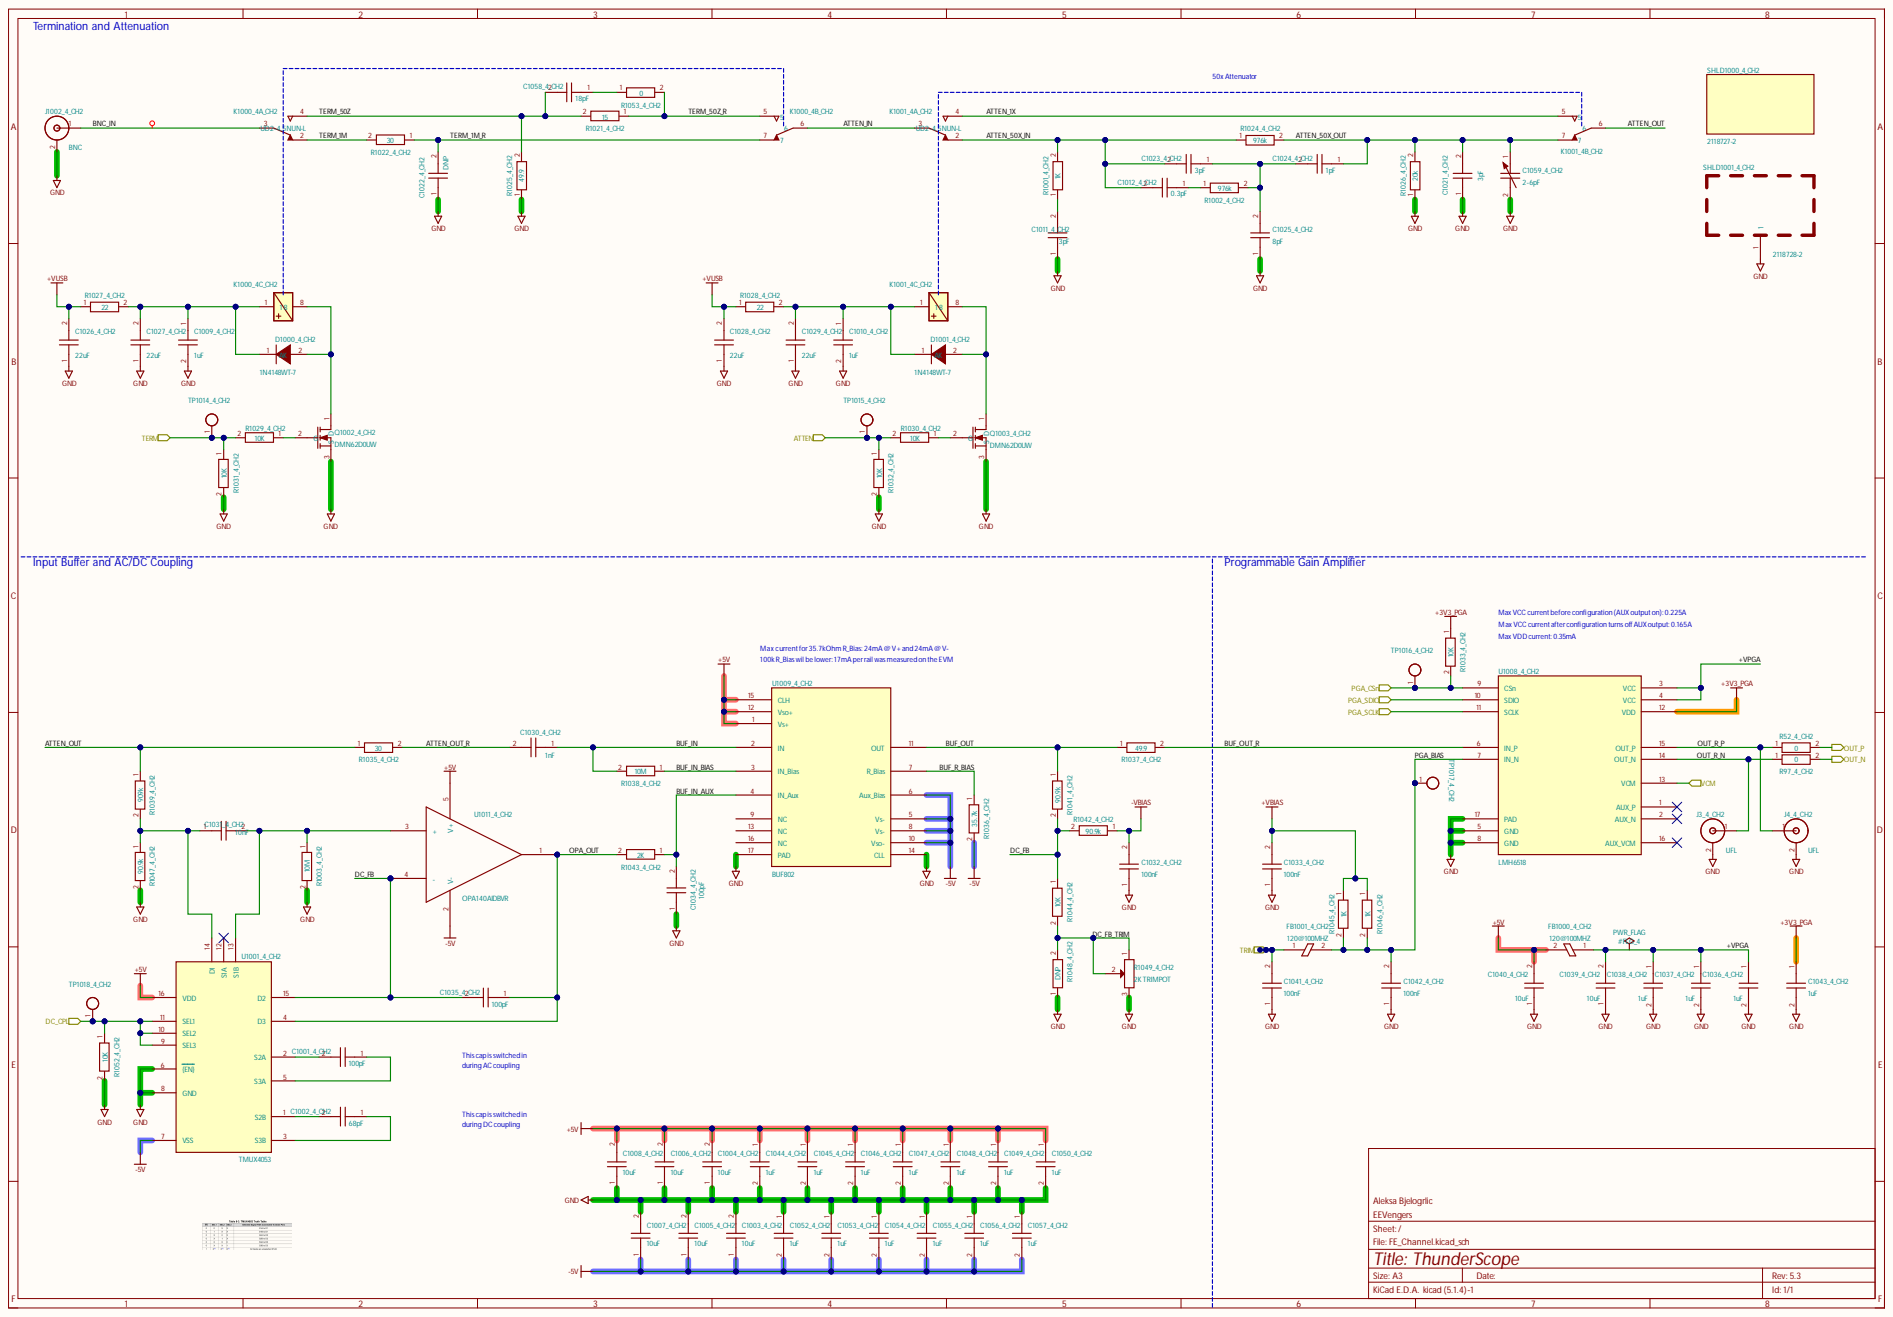
[picture p15: page 9]

Input Buffer and AC/DC Coupling

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

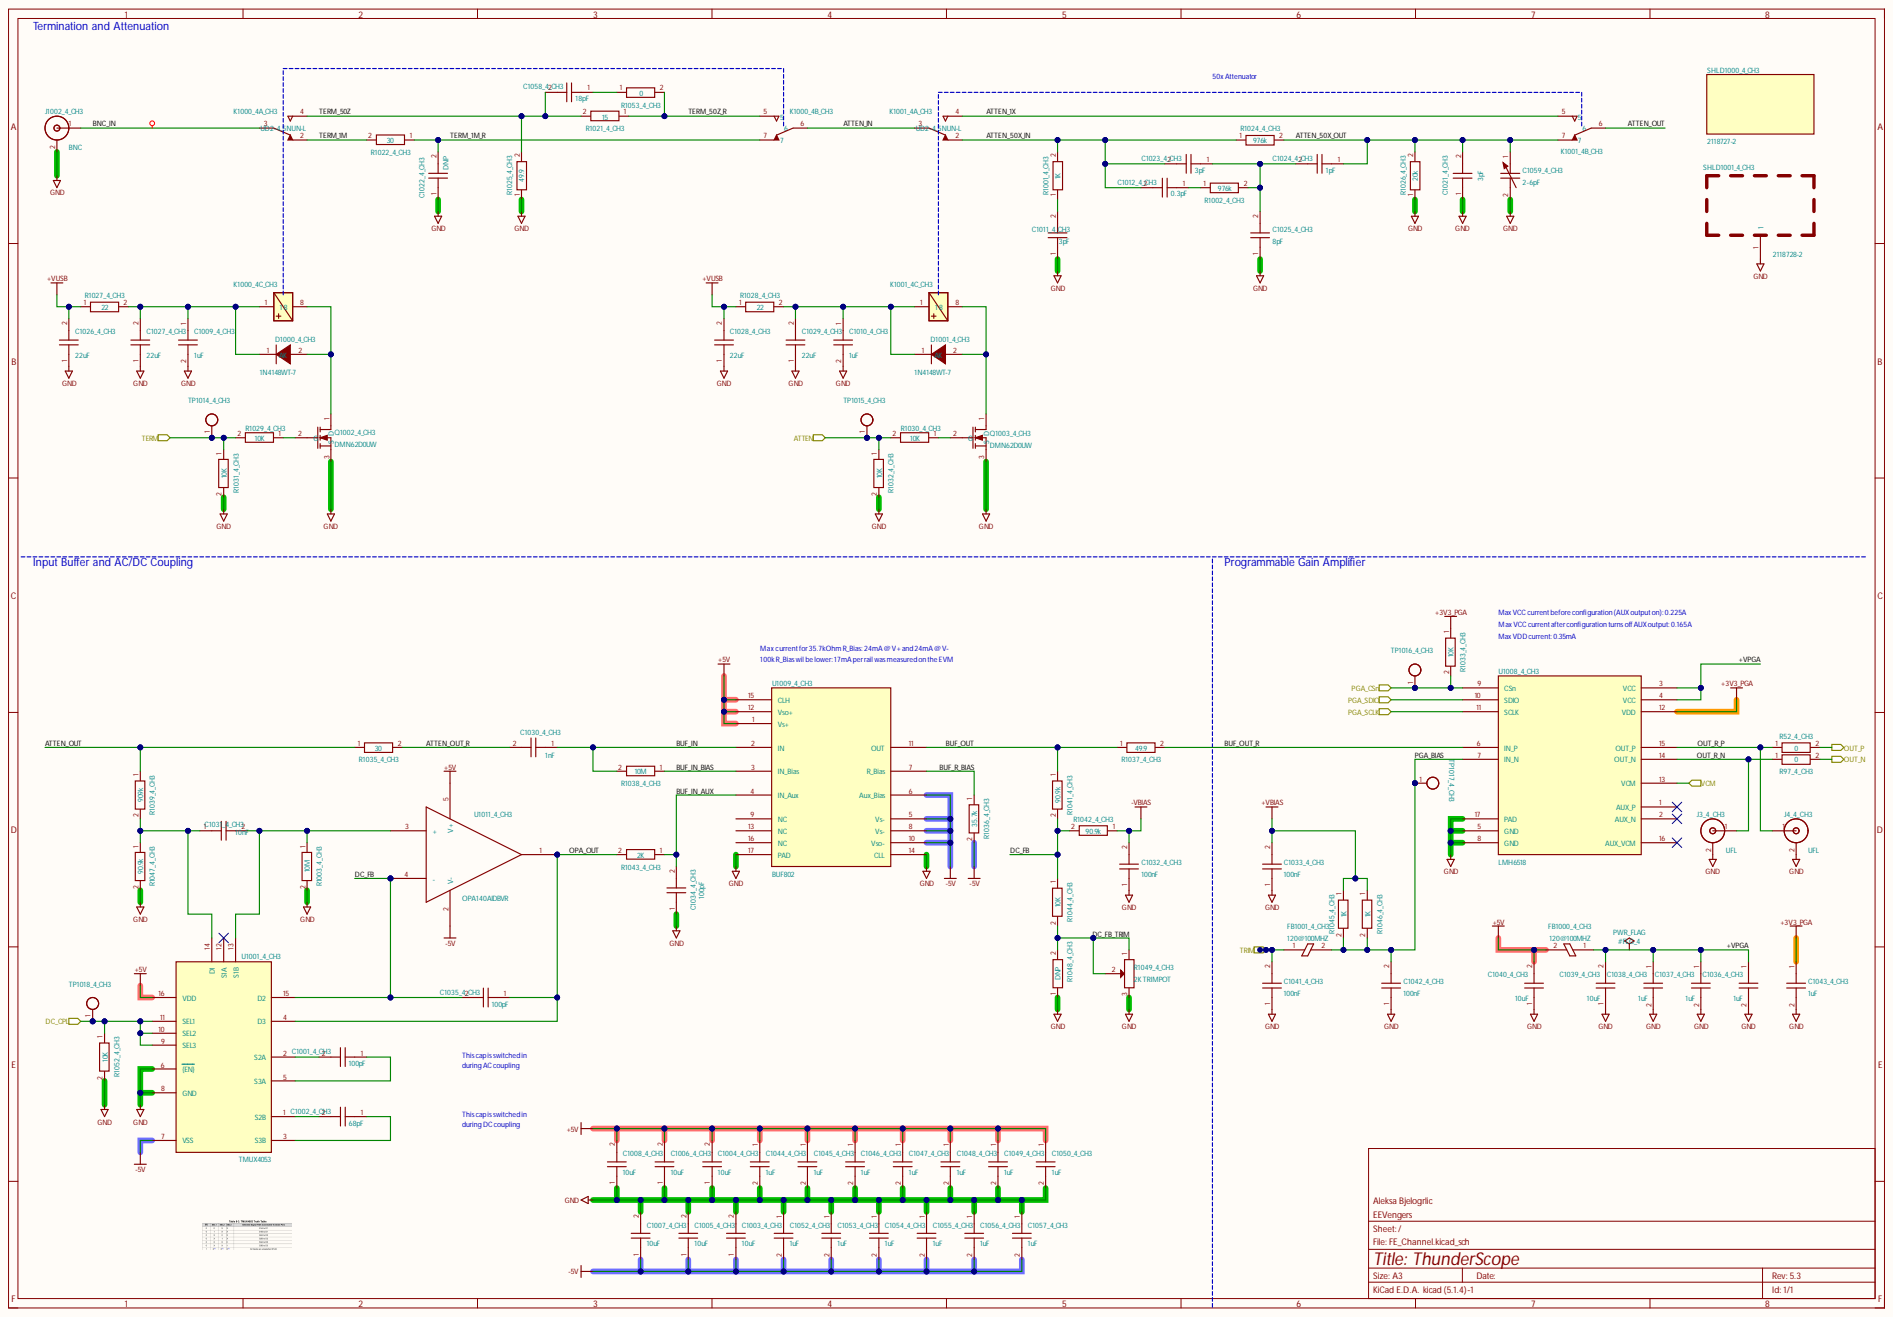
[picture p16: page 10]

Input Buffer and AC/DC Coupling

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

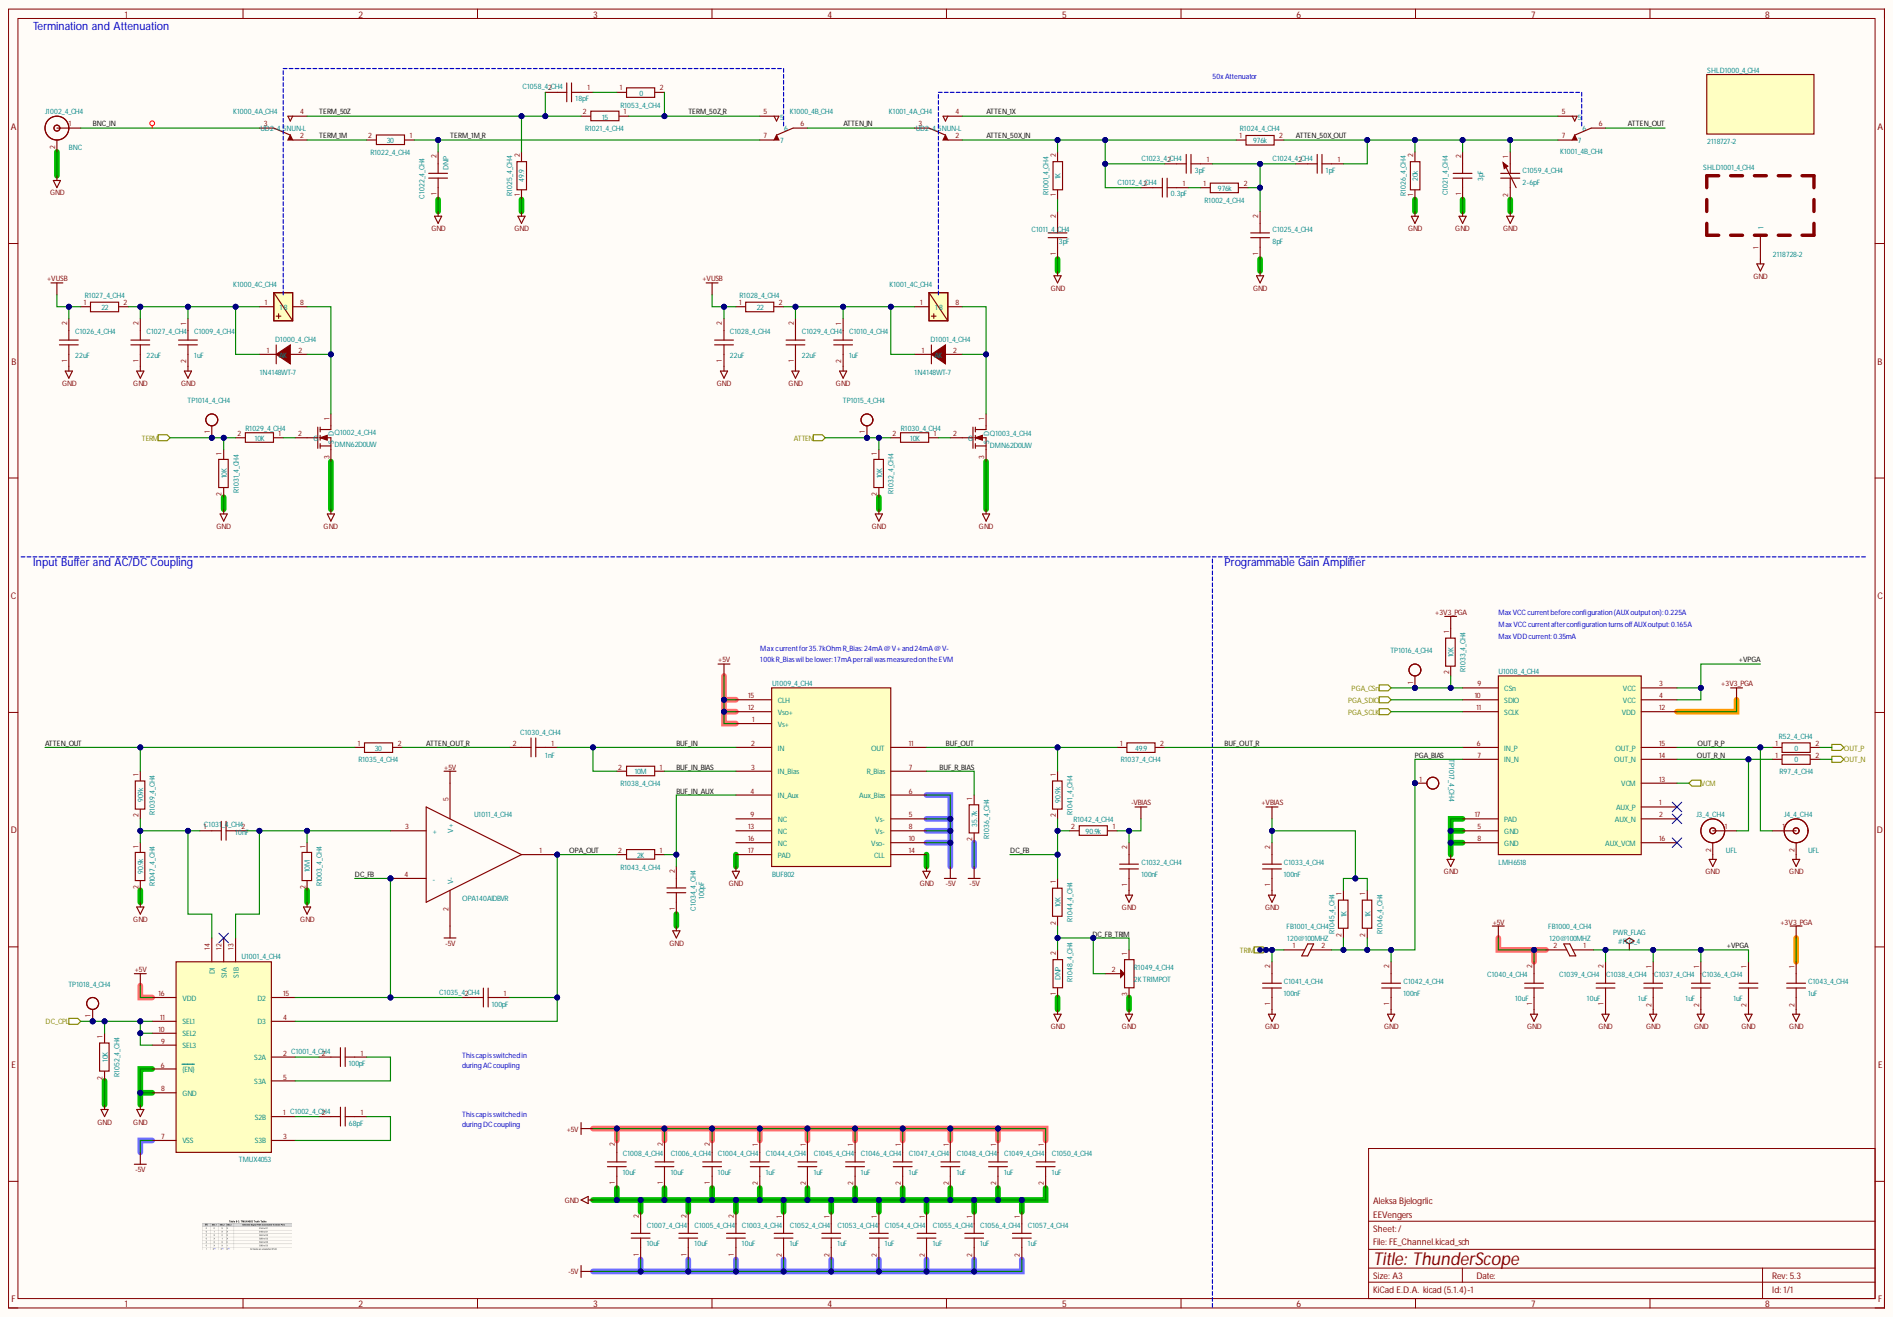
[picture p17: page 11]

Input Buffer and AC/DC Coupling

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

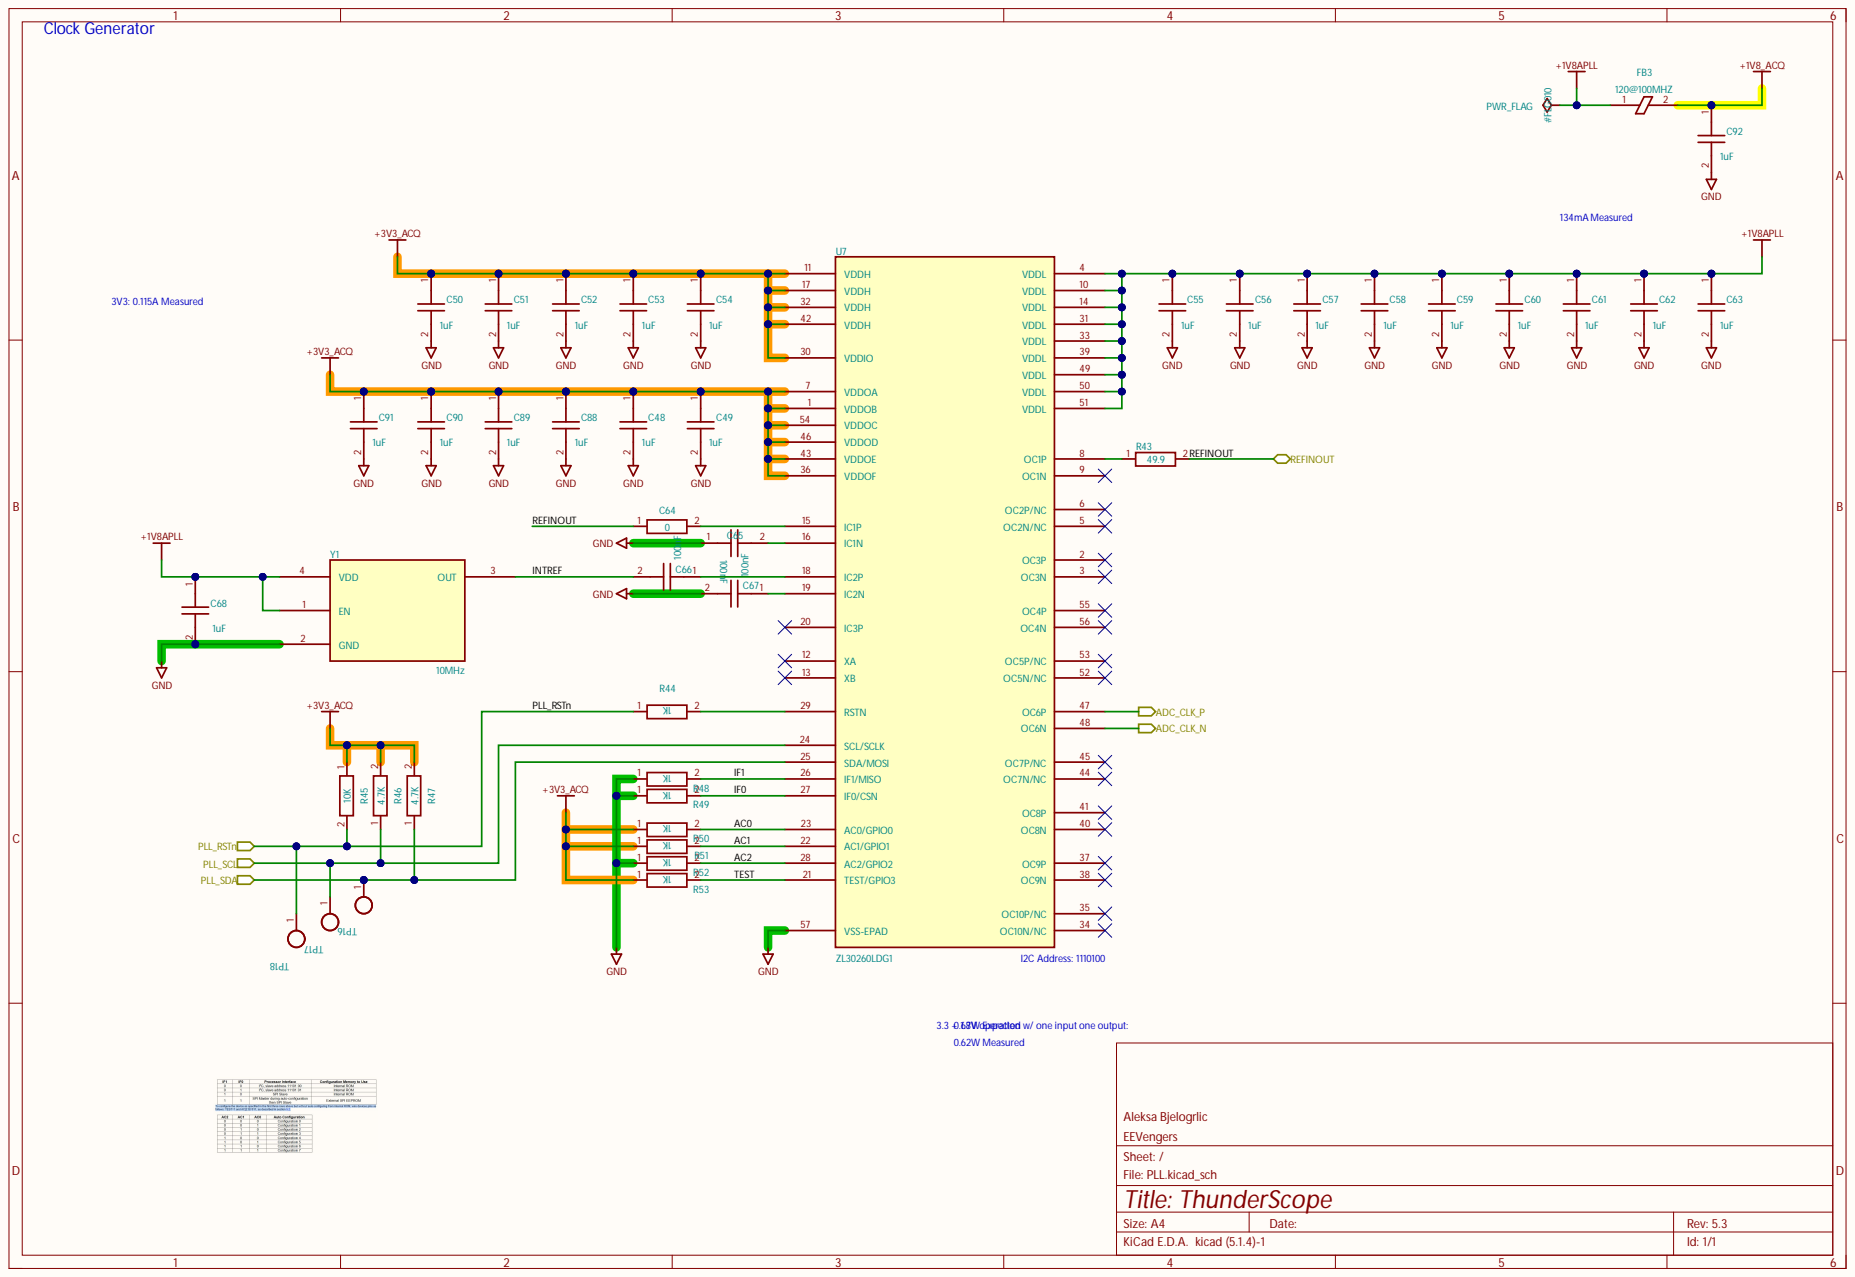
[picture p18: page 12]

VDDH 17 | R43

VDDH 42

VDDIO 30

C64 | VDDOB 1

SDA/MOSI 25
IF1/MISO 26

R48 IF0 | IF0/CSN 27

3.3 + 1.8V operation w/ one input one output:
0.67W Expected
0.62W Measured

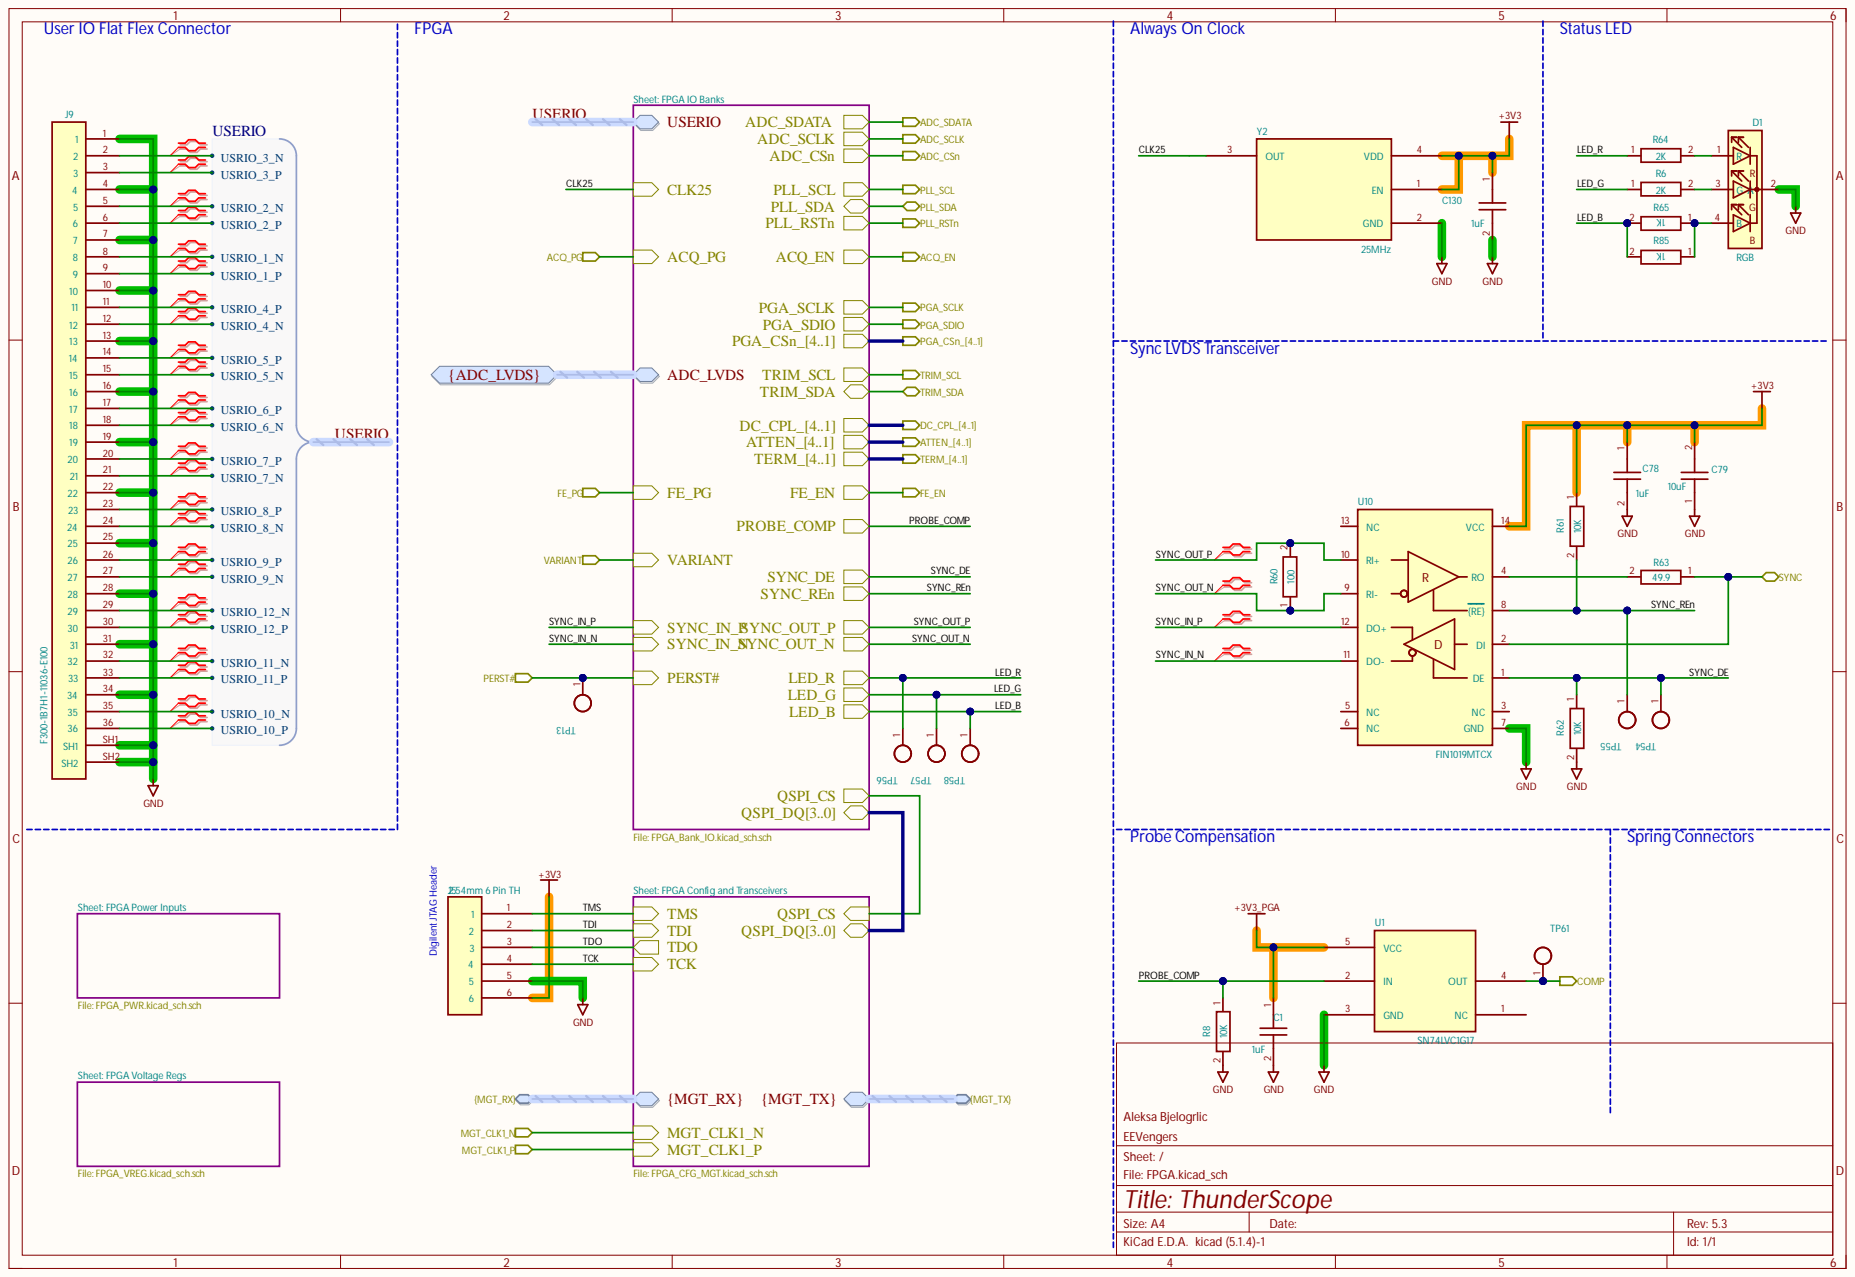
[picture p19: page 13]

Always On Clock Sync LVDS Transceive

K i Cad E.D.A. k i cad (5.1.4)-1

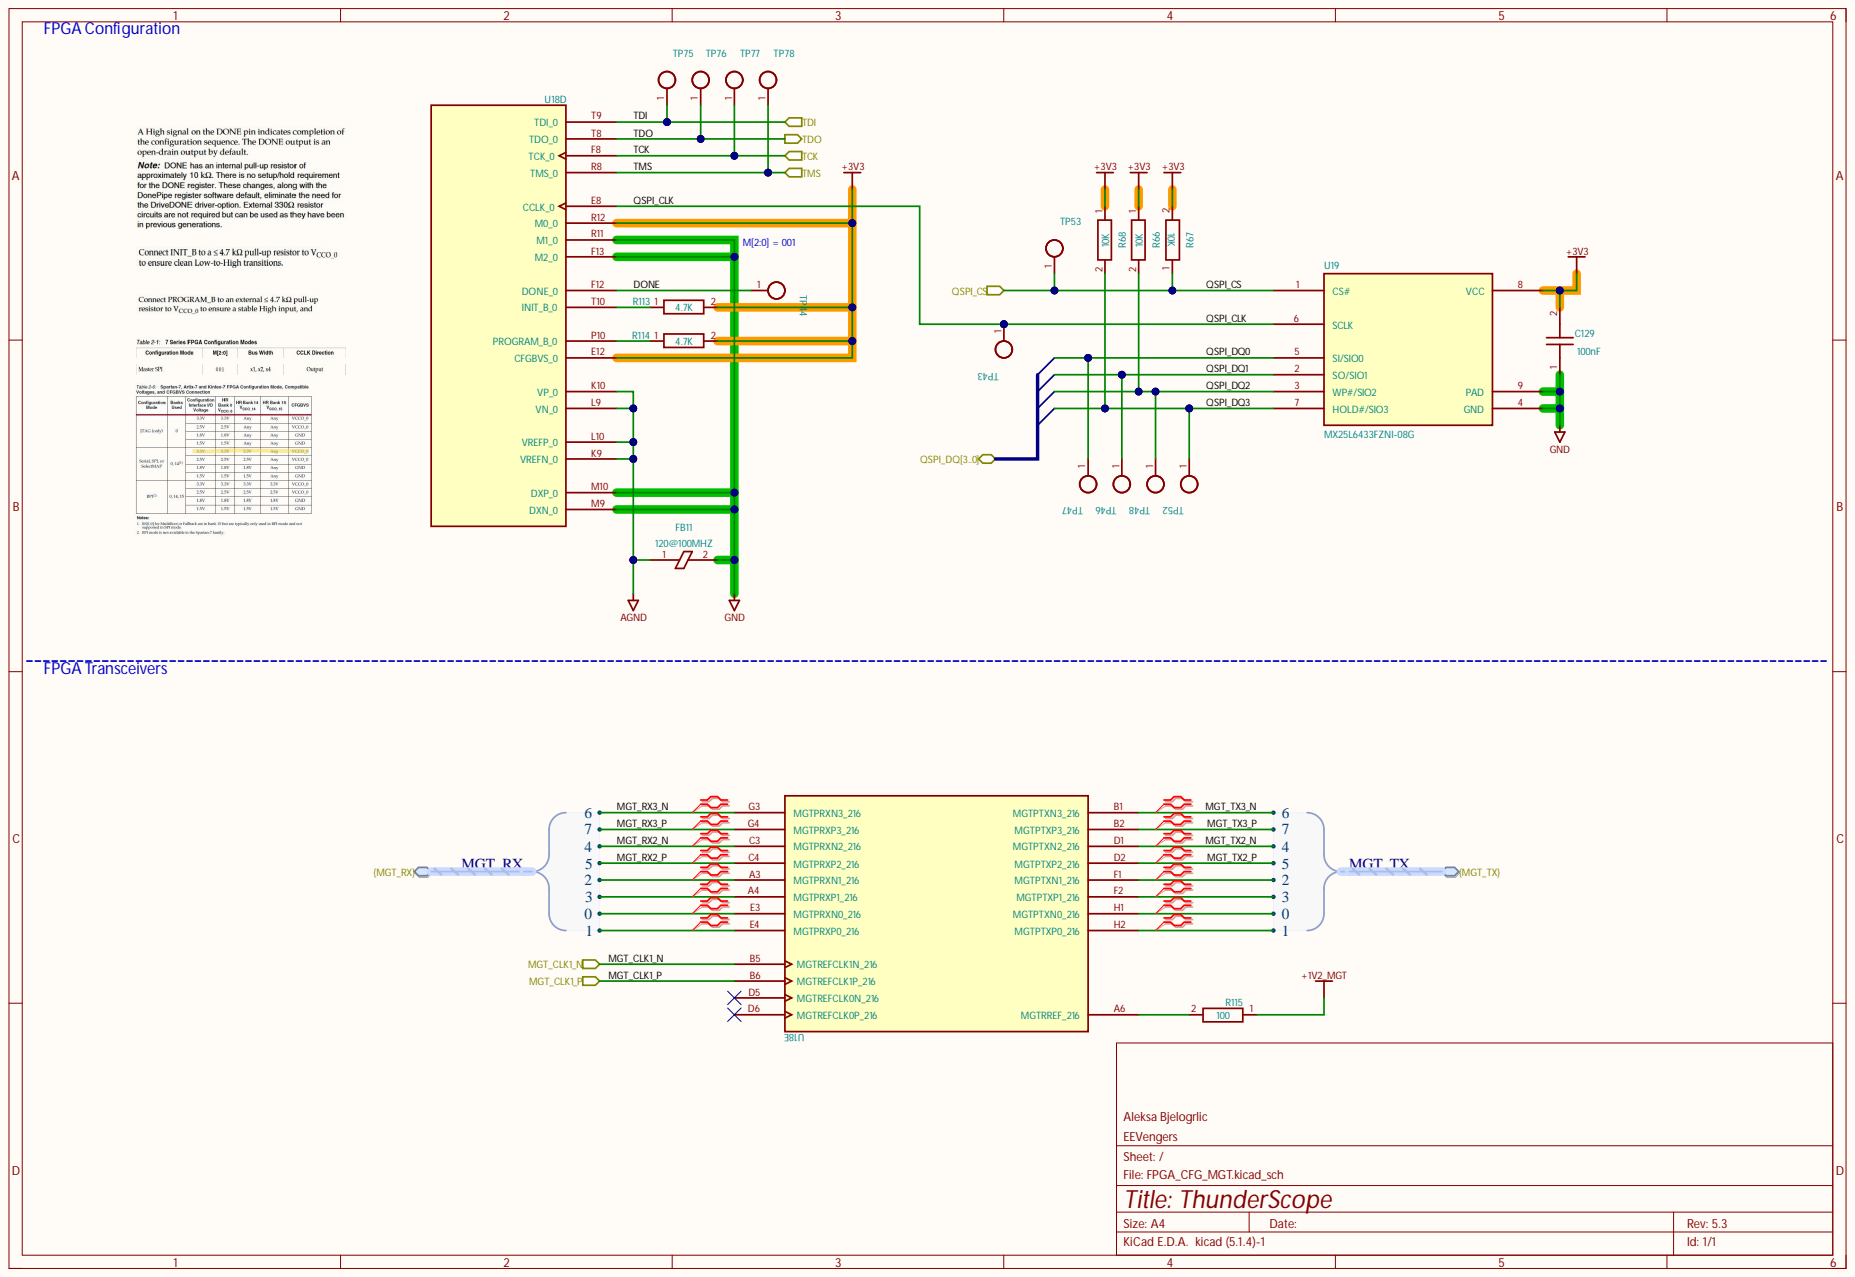
[picture p20: page 14]

TDO
TCK

QSPI_CLK | SCLK 6

QSPI_DQ0 | SI/SIO0 5
QSPI_DQ1 | SO/SIO1 2
QSPI_DQ2 | WP#/SIO2 3
QSPI_DQ3

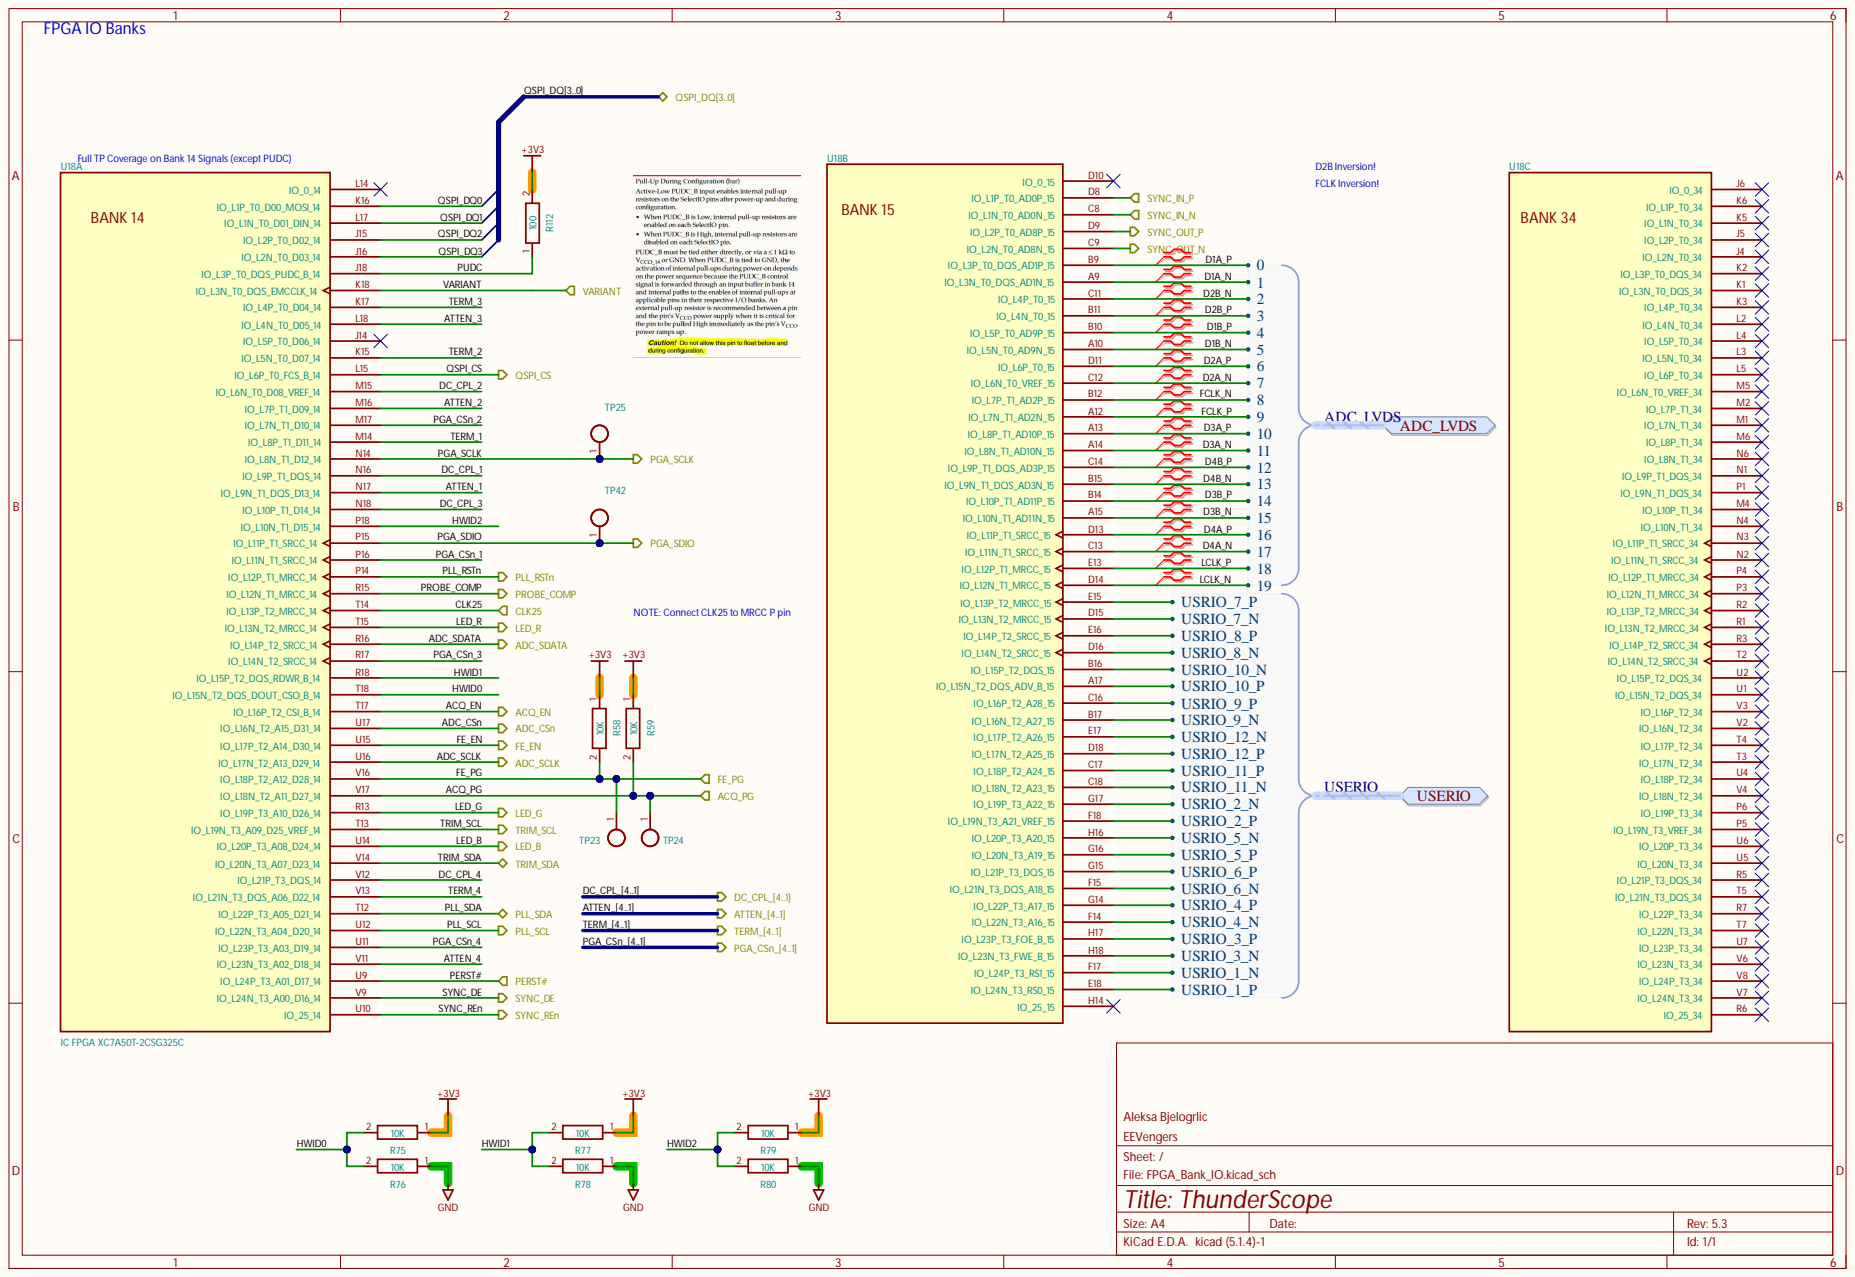
[picture p21: page 15]

K i Cad E.D.A. k i cad (5.1.4)-1

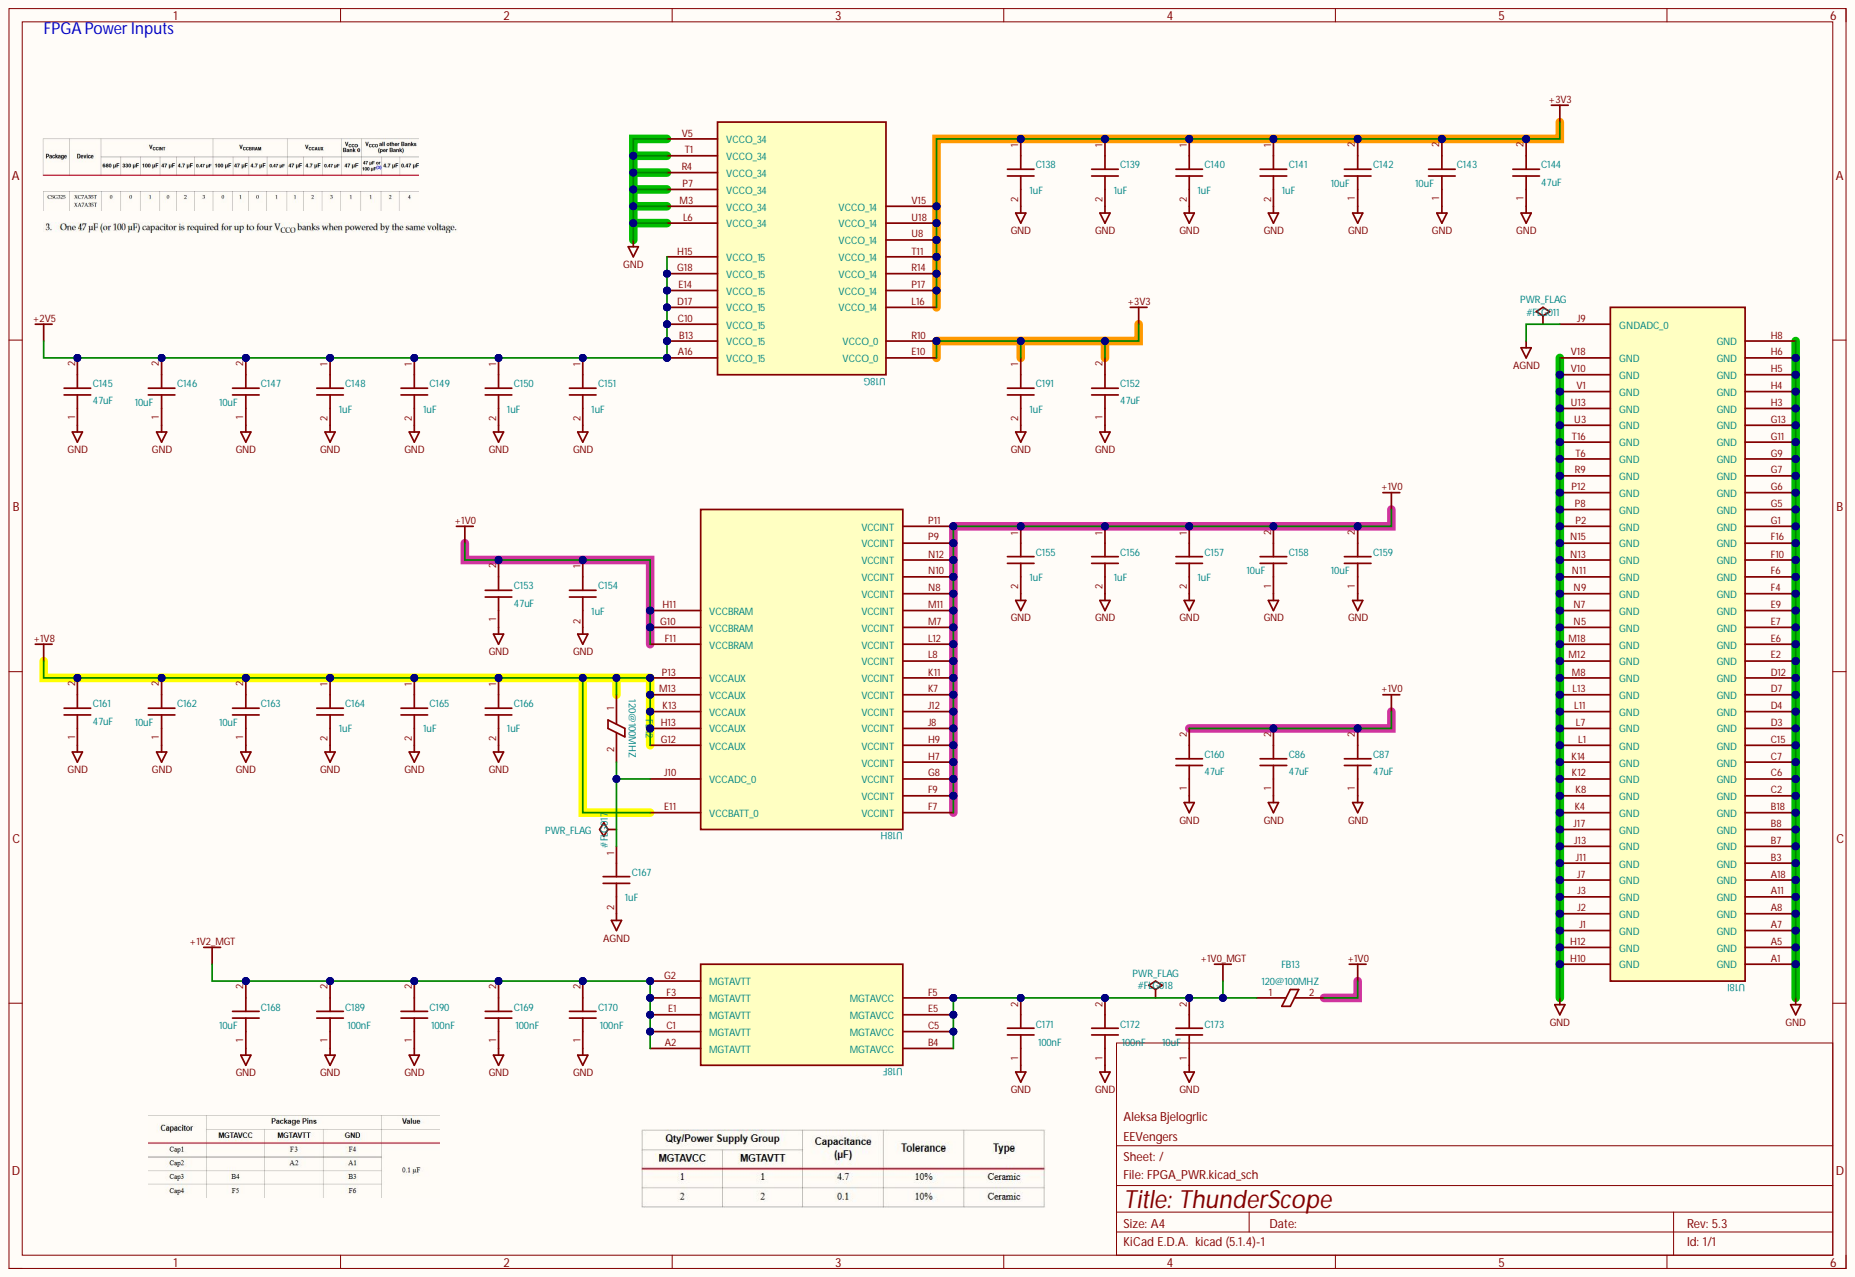
[picture p22: page 16]

L 6 | U 1 8
H 1 5 | U 8

GND V18 D V10 | H 5

D V1 | H 4
U 1 3 | | H 3
U 3 | | 3

L 8 | | | D M12
K 1 1 | | D M8 | 2

D J13 | B 7
D J11 | B 3
D J7 | A 1 8
D J3 | A 1 1
D J2 | A 8
D J1 | A 7
H 1 2 | | A 5
H 1 0 | | A 1

K i Cad E.D.A. k i cad (5.1.4)-1

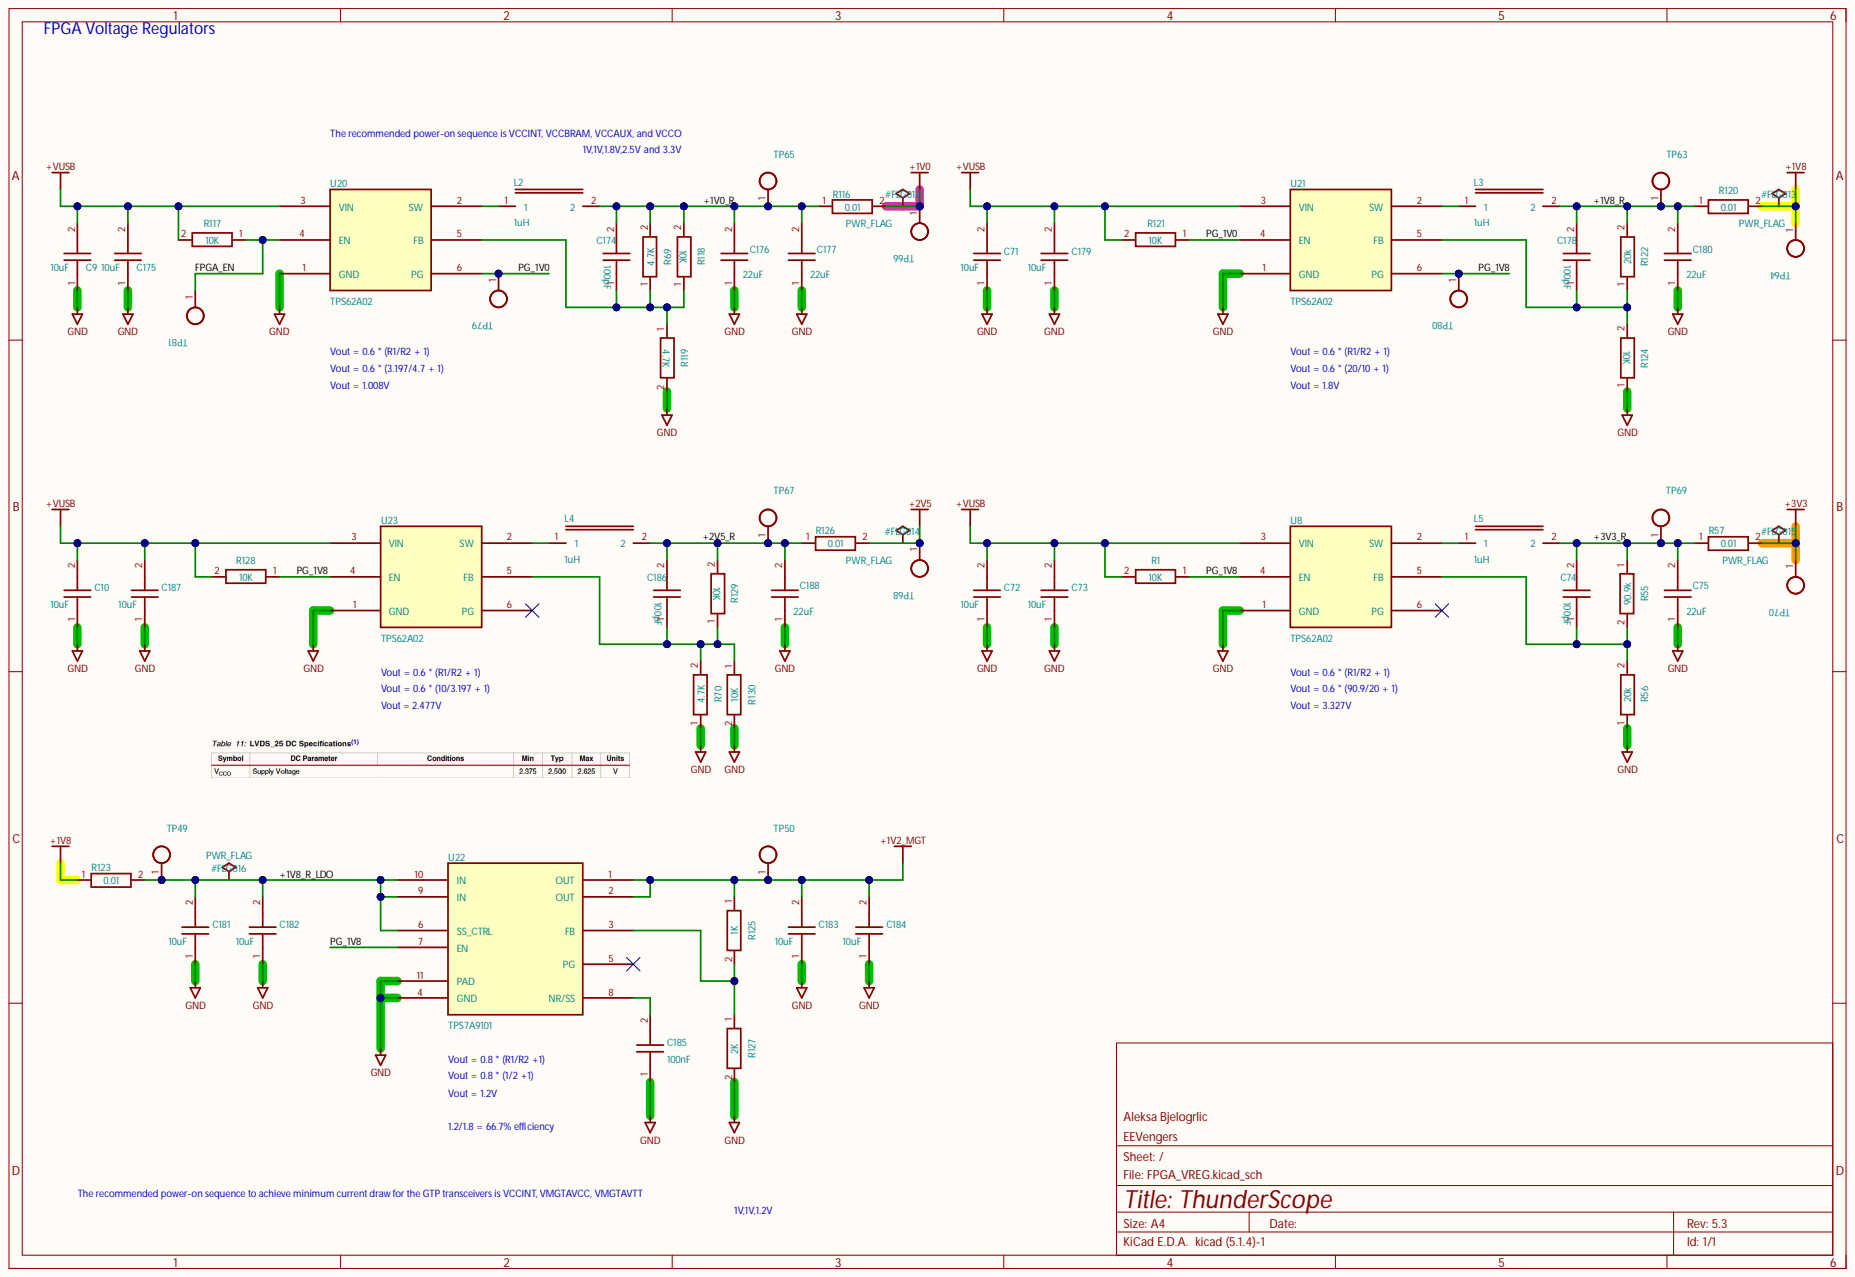
[picture p23: page 17]

The recommended power-on sequence is VCCINT, VCCBRAM, VCCAUX, and VCCO

The recommended power-on sequence to achieve minimum current draw for the GTP transceivers is VCCINT, VMGTAVCC, VMGTAVTT

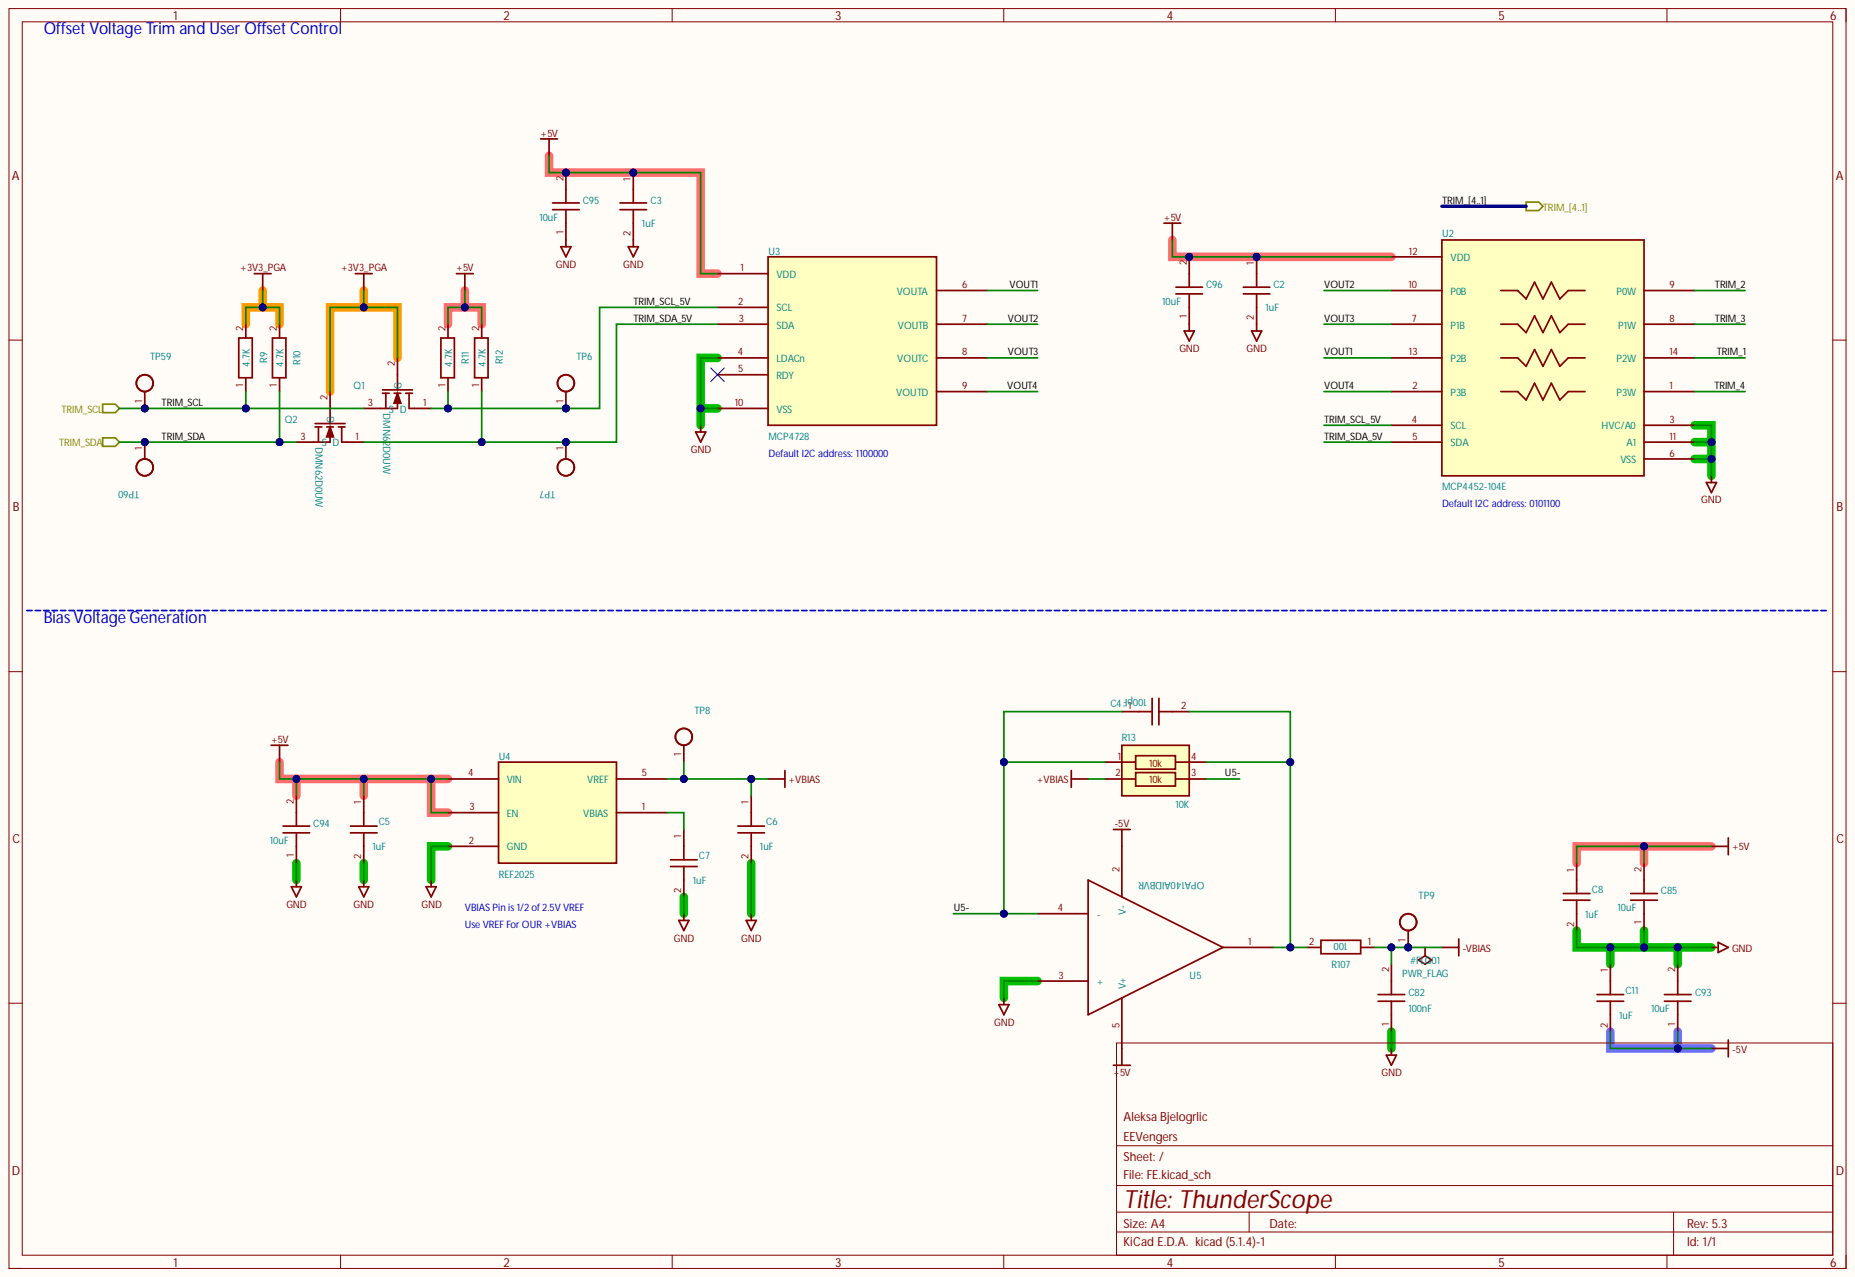
[picture p24: page 18]

Offset Voltage Trim and User Offset Control

VBIAS Pin is 1/2 of 2.5V VREF
Use VREF For OUR +VBIAS

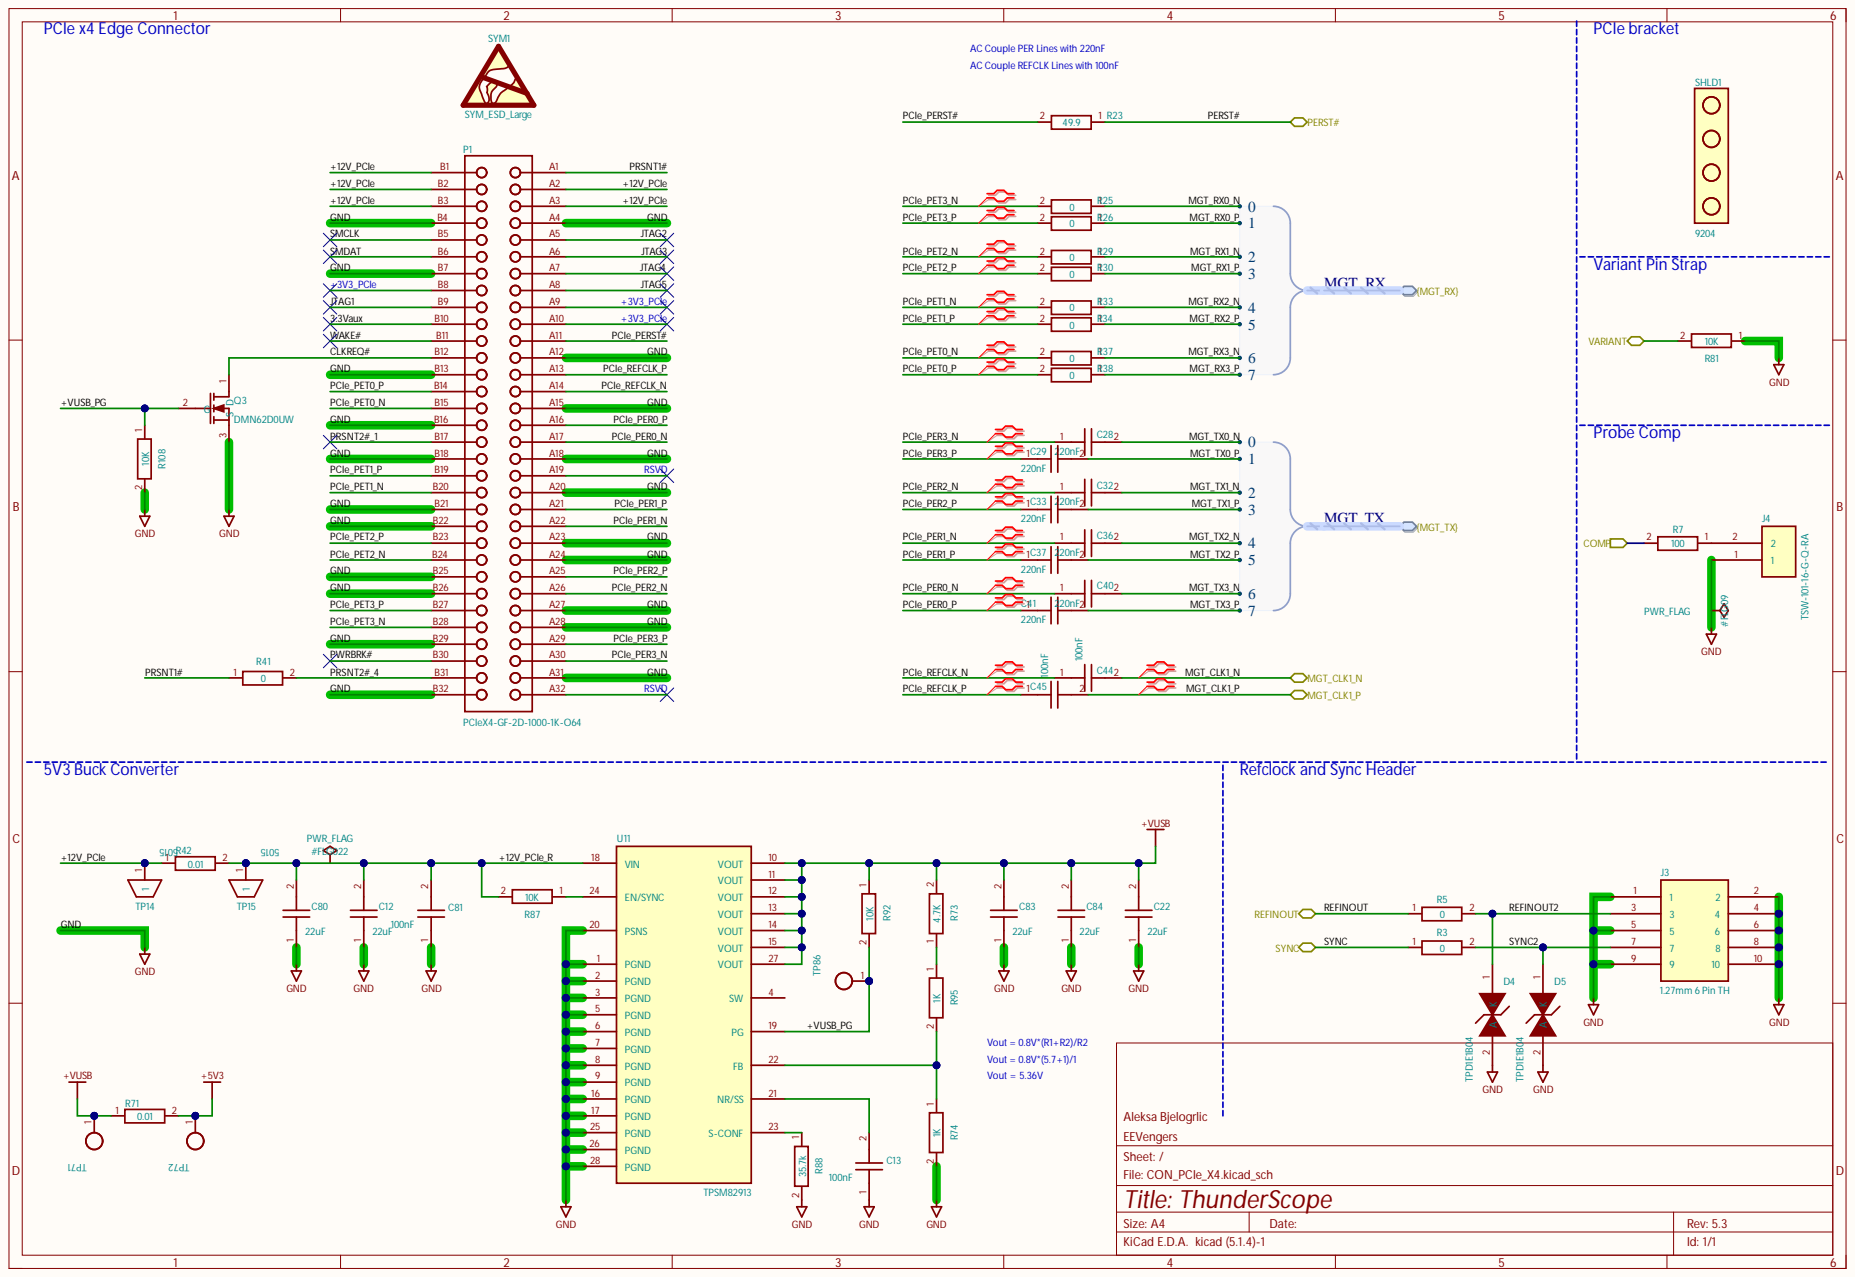
[picture p25: page 19]

AC Couple PER Lines with 220nF
AC Couple REFCLK Lines with 100nF

Refclock and Sync Header

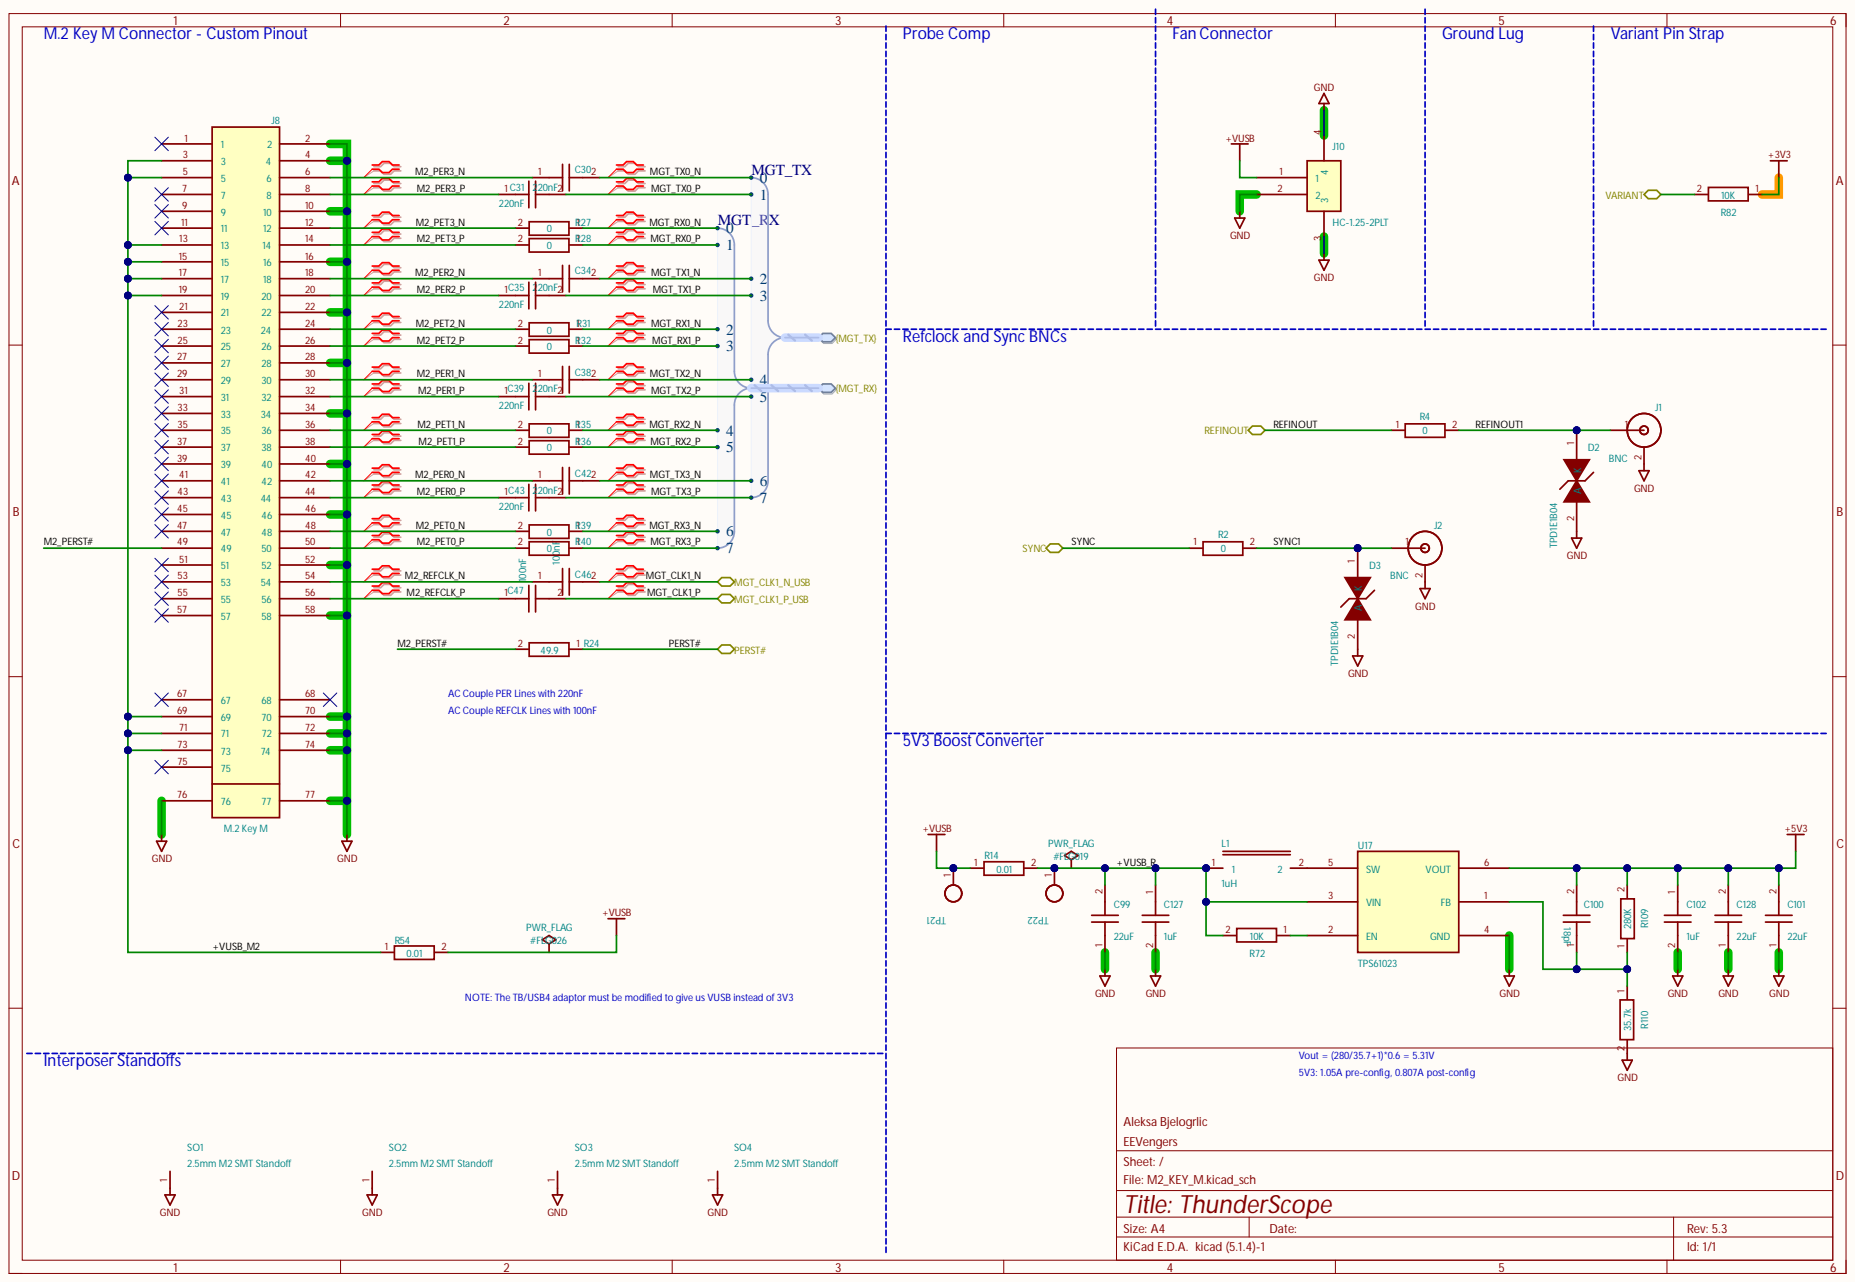
[picture p26: page 20]

5 5
7 7 | M2_PER3_P C31

Refclock and Sync BNCs

AC Couple PER Lines with 220nF
AC Couple REFCLK Lines with 100nF

NOTE: The TB/USB4 adaptor must be modified to give us VUSB instead of 3V3

Vout = (280/35.7+1)*0.6 = 5.31V
5V3: 1.05A pre-config, 0.807A post-config
