dj140/ThunderScope/(list of files, drawings)

Other design files:
Hardware_V5.3_AD/ACQ_FE_VREG.SchDoc
Hardware_V5.3_AD/ACQ_FE_VREG.SchLib
Hardware_V5.3_AD/ADC.SchDoc
Hardware_V5.3_AD/ADC.SchLib
Hardware_V5.3_AD/ADC_Driver.SchDoc
Hardware_V5.3_AD/ADC_Driver.SchLib
Hardware_V5.3_AD/CON_PCIe_X4.SchDoc
Hardware_V5.3_AD/CON_PCIe_X4.SchLib
Hardware_V5.3_AD/FE.SchDoc
Hardware_V5.3_AD/FE.SchLib
Hardware_V5.3_AD/FE_Channel.SchDoc
Hardware_V5.3_AD/FE_Channel.SchLib
Hardware_V5.3_AD/FPGA.SchDoc
Hardware_V5.3_AD/FPGA.SchLib
Hardware_V5.3_AD/FPGA_Bank_IO.SchDoc
Hardware_V5.3_AD/FPGA_Bank_IO.SchLib
Hardware_V5.3_AD/FPGA_CFG_MGT.SchDoc
Hardware_V5.3_AD/FPGA_CFG_MGT.SchLib
Hardware_V5.3_AD/FPGA_PWR.SchDoc
Hardware_V5.3_AD/FPGA_PWR.SchLib
Hardware_V5.3_AD/FPGA_VREG.SchDoc
Hardware_V5.3_AD/FPGA_VREG.SchLib
Hardware_V5.3_AD/M2_KEY_M.SchDoc
Hardware_V5.3_AD/M2_KEY_M.SchLib
Hardware_V5.3_AD/PLL.SchDoc
Hardware_V5.3_AD/PLL.SchLib
Hardware_V5.3_AD/Thunderscope_Rev5.3.PcbDoc
Hardware_V5.3_AD/Thunderscope_Rev5.3.PcbLib
Hardware_V5.3_AD/Thunderscope_Rev5.3.PrjPcb
Hardware_V5.3_AD/Thunderscope_Rev5.3.SchDoc
Hardware_V5.3_AD/Thunderscope_Rev5.3.SchLib
Hardware_V5.3_AD/Thunderscope_Rev5.SCHLIB
