dj140/ThunderScope/(commit log)

2026-08-29 add Altium vesion
    [ACQ_FE_VREG.SchDoc, ACQ_FE_VREG.SchLib, ADC.SchDoc, ADC.SchLib, ADC_Driver.SchDoc, ADC_Driver.SchLib, CON_PCIe_X4.SchDoc, CON_PCIe_X4.SchLib]
2026-09-04 update layout
    [ACQ_FE_VREG.SchDoc, ADC.SchDoc, ADC_Driver.SchDoc, CON_PCIe_X4.SchDoc, FE.SchDoc, FE_Channel.SchDoc, FPGA.SchDoc, FPGA_Bank_IO.SchDoc]
2026-09-15 Production Version_1
    [Thunderscope_Rev5.3.GBL, Thunderscope_Rev5.3.GBO, Thunderscope_Rev5.3.GBP, Thunderscope_Rev5.3.GBS, Thunderscope_Rev5.3.GKO, Thunderscope_Rev5.3.GM1, Thunderscope_Rev5.3.GTL, Thunderscope_Rev5.3.GTO]
